bandolibre/bandolibre/README.md

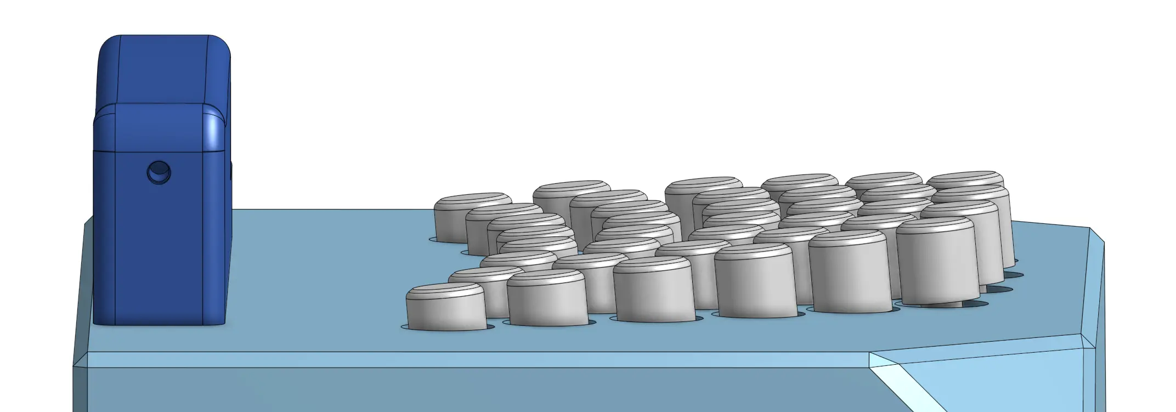
[picture p1: docs/guide/images/3dmodel_keyboard_tilt.webp]
Bandolibre keyboard


🇬🇧 **English** | 🇫🇷 [Français](README.fr.md) | 🇪🇸 [Español](README.es.md)

# Bandolibre

An open-source MIDI controller that brings the Argentine bandoneon into the digital age.

**Bandolibre focuses on one goal:** turning key presses and bellows movement into MIDI — faithfully, instantly, and without the cost or noise of an acoustic instrument. Plug it into any computer, tablet, or phone over USB and you're ready to play, compose, or practice.

An open initiative by [L'Atelier du bandonéon libre](https://github.com/bandolibre)

---

## See it play

Bandolibre demo with a clarinet virtual instrument (https://youtu.be/6s1wlRKlAk4)

Watch the demos: [with a clarinet virtual instrument](https://youtu.be/6s1wlRKlAk4) · [with strings virtual instruments](https://youtu.be/nJ0j7DtbYDk).

---

## Who is it for?

- **Students** who don't own an instrument yet and want to start learning
- **Players** who want to practice silently — at home, on the road, at any hour
- **Composers** entering scores into notation software one note at a time
- **Musicians** triggering synths and samplers on stage or in the studio

---

## How it works

- **142-key Rheinische Lage layout** — both hands, exact fingering of the Argentine bandoneon
- **Hall-effect sensors** on every key — no mechanical contact, no wear, scanned 2400 times per second
- **Blade spring + sensor pair** for the bellows — measures push/pull effort and emits MIDI CC#11 (Expression), just like the real thing
- **Two 6.35 mm expression pedal inputs** — compatible with M-Audio EX-P pedals; pedal 1 sends CC#1 (Modulation), pedal 2 sends CC#4 (Foot Controller)
- **USB-MIDI** out of the box — plug into any DAW, notation app, or synth; no drivers needed

---

## Features

**Keyboard system** — a button cycles through the three keyboard systems: Rheinische Tonlage (bisonoric, 142 tones), Peguri, or Manoury.

**Table mode** — a button toggles table mode: keys fire immediately at fixed velocity, no bellows movement required. Handy for entering a score note by note without working the bellows.

**Play anywhere** — Bandolibre is bus-powered over USB; any phone, tablet, or laptop with a soft synth becomes the sound engine. A small USB hub with a headphone jack and a power pass-through gives you audio, charging, and MIDI from a single cable — tested and pocket-sized.

**Adaptable** — standard USB-MIDI is compatible with the whole adapter ecosystem: plug in a USB Bluetooth MIDI adapter to play wirelessly, or a USB-to-DIN-5 adapter to drive vintage hardware synths.



---

## Anyone can build it

This is a fully open DIY project. PCBs are designed for economic JLCPCB two-layer fabrication — affordable and easy to order. The mechanical parts are 3D-printable (a FabLab near you works great). Firmware is open-source and flashable with a standard [ST-LINK probe](https://www.st.com/en/development-tools/stlink-v3minie.html) and a [TC-2070-IDC-050](https://www.tag-connect.com/product/tc2070-idc-050) cable.

Building one costs about as much as a decent MIDI keyboard or a good pair of studio headphones like the DT-770 Pro.

The parts list, tools, consumables and step-by-step assembly are in the assembly instructions:



They are best built in batches of five — JLCPCB minimum orders make that the natural unit. Team up with friends or reach out to [L'Atelier du bandonéon libre](https://github.com/bandolibre) to express interest in a community build.

At fifty units, PCB fabrication and Gateron switches — the two biggest line items — drop by half again.

- **Firmware:** see [`code/`](code/) — build with `just build` and `just flash`, flash via ST-LINK
- **Firmware updates:** from the browser with the [software update tool](https://bandolibre.github.io/bandolibre/update/), over the USB cable; or hold the left function button at power-on and drop the `.uf2` file onto the drive that appears — no programmer needed

---

## Configuration tool

The configuration tool is a web page that displays and changes the instrument's parameters over USB-MIDI — it works on a computer, tablet or phone. It lets you tune the bellows by dragging the push and pull curves (or picking a preset) to shape how effort turns into expression, and calibrate the rest position. Changes apply immediately, so you can adjust the feel while playing. It also calibrates the pedals, switches keyboard system, bellows program and table mode, edits every firmware property, and shows both keyboards live as you play.



<p>
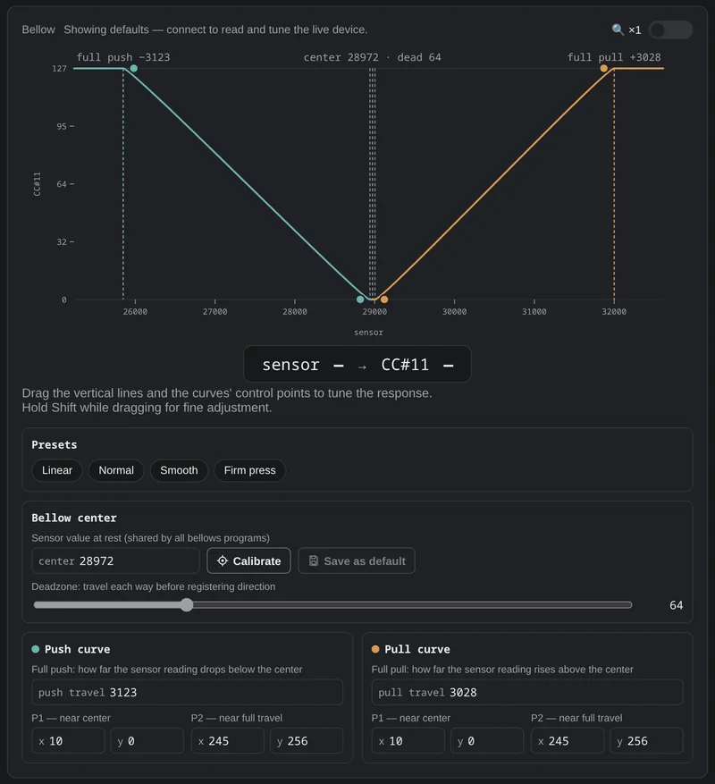
[picture p2: docs/guide/images/configuration_tool.webp]
Configuration tool, bellows curve
  
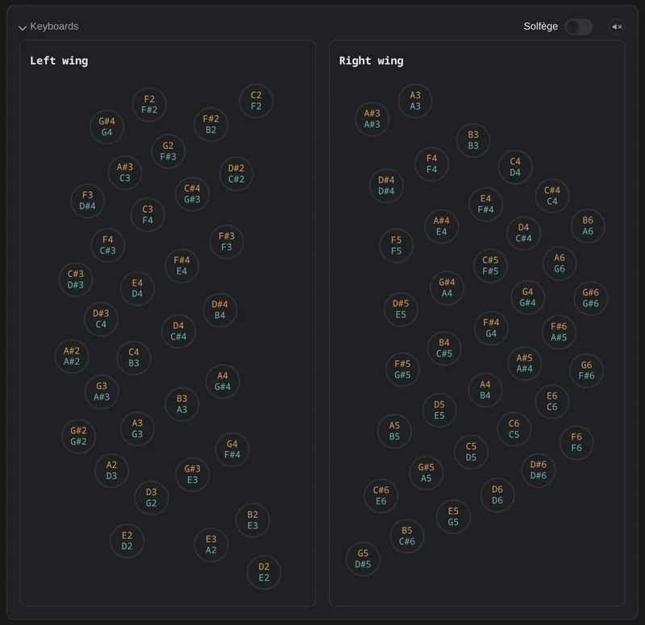
[picture p3: docs/guide/images/configuration_tool_keyboard.webp]
Configuration tool, live keyboards
  
</p>

---

## Software update

The software update tool installs the latest firmware from the browser, over the same USB cable — nothing to install, no button to hold. It shows the installed version, says when an update is available and follows every page as it is written and checked. An interrupted update is safe: the instrument waits in its update mode until it is resumed.



---

## Design

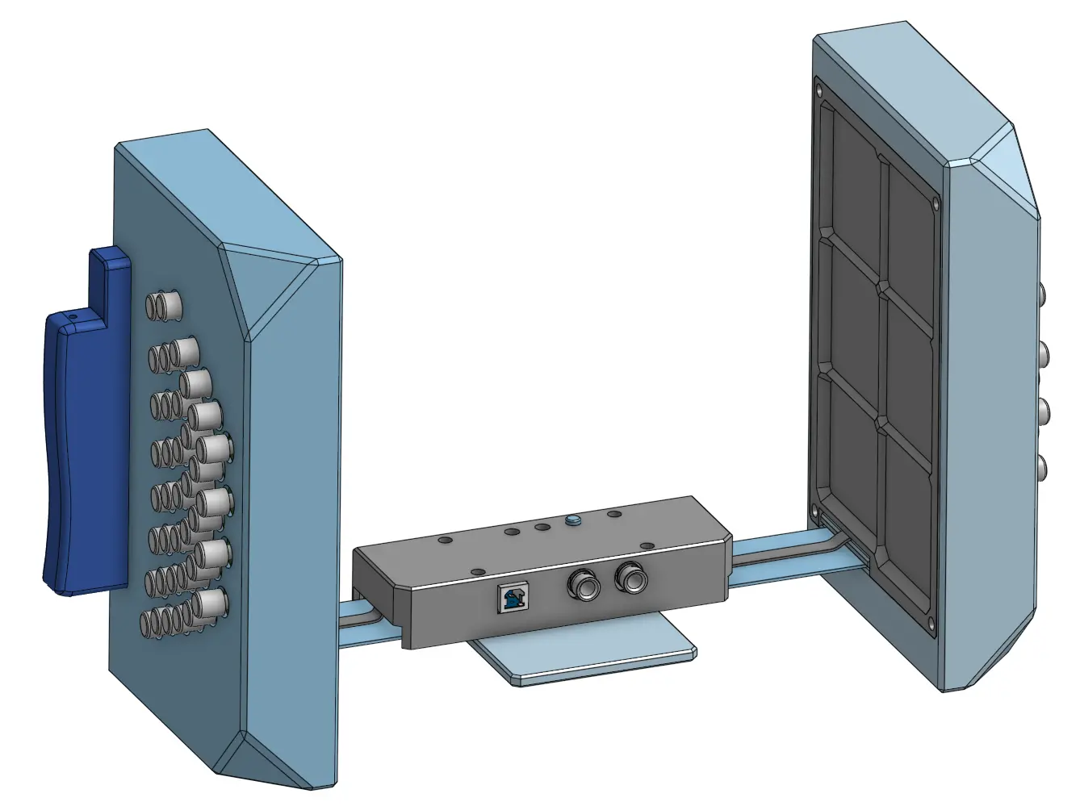
[picture p4: docs/guide/images/3dmodel_overview.webp]
overview


The mechanical parts are modeled in Onshape — [the full 3D model](https://cad.onshape.com/documents/313e70e978bf056a8dd7d76c/v/5c5fbc4088ac379c1bd1b53a/e/c6a89cb028bdc195ff70596f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) is public and interactive. Reference [photography](keyboard_picture/) of real instruments was used to accurately reproduce the shape, key placement, and keyboard tilt of both hands.
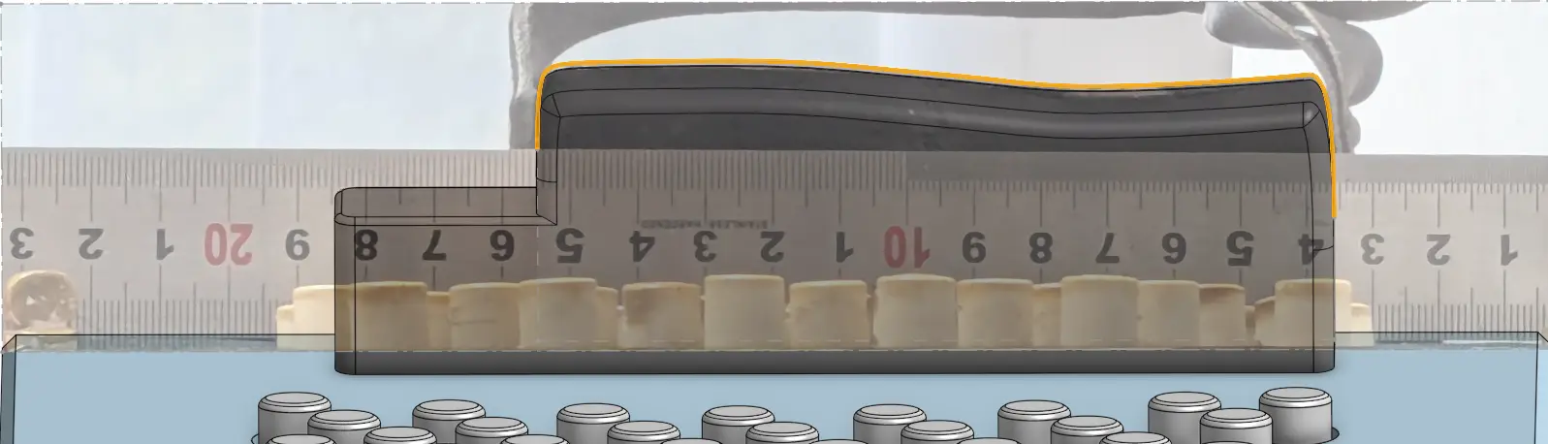
[picture p5: docs/guide/images/3dmodel_handle.webp]
handle_layout

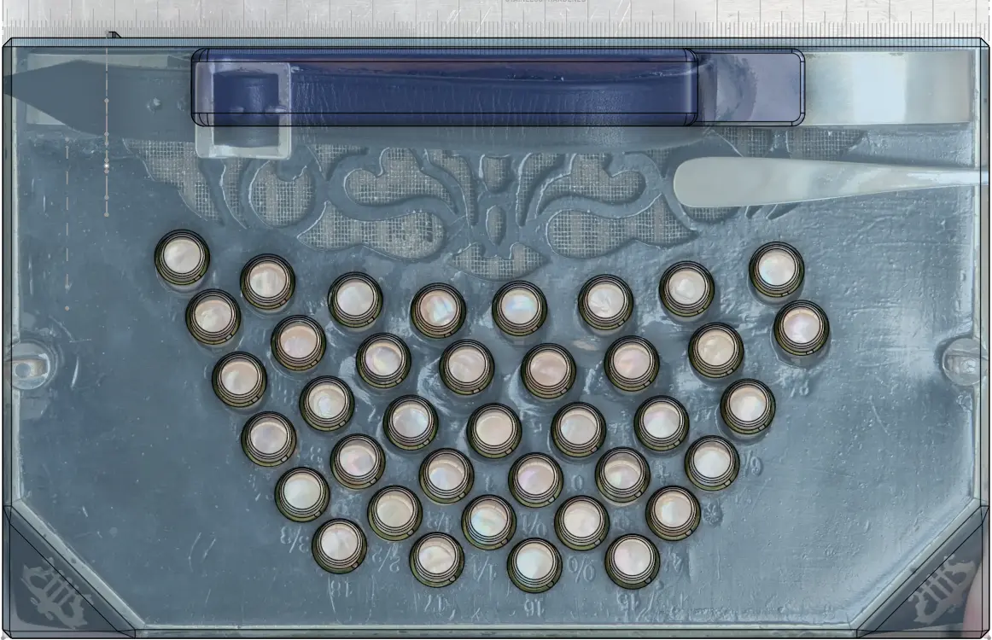
[picture p6: docs/guide/images/3dmodel_keyboard_layout.webp]
keyboard_layout


The PCBs are designed with EasyEDA.
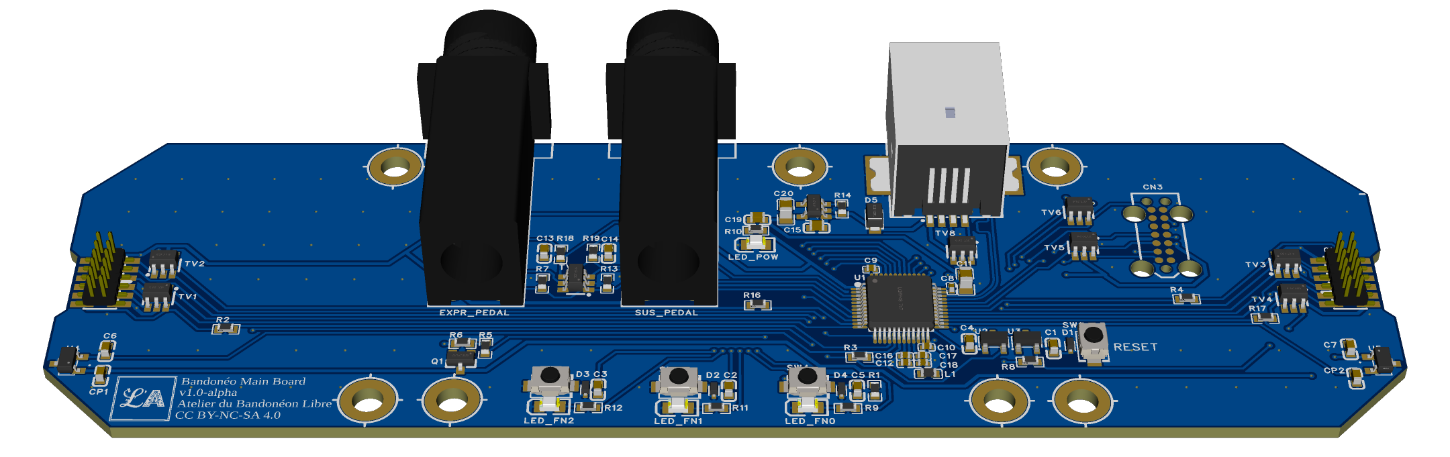
[picture p7: docs/guide/images/pcb_main_board_3d.png]
3d_pcb


The bellows is replaced by a **blade spring instrumented with two Hall-effect sensors** that read its flexion. Load cell solutions were ruled out early — they are too rigid and remove the tactile feedback players rely on to feel and modulate their effort — it plays like pressing on a wall. The blade spring preserves that proprioceptive feedback while being simple and durable. Blade thickness can be chosen to tune the instrument's stiffness, from light to firm.

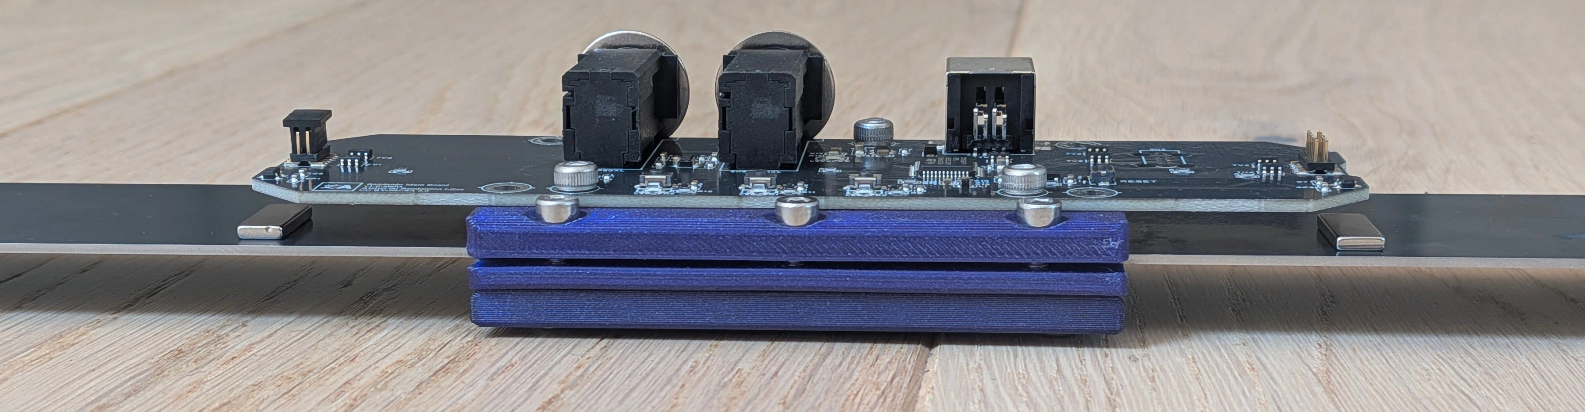
[picture p8: docs/guide/images/bandolibre_blade.webp]
blade spring


A bellows program button cycles through three bellows programs, each with its own rest position, dead zone, full travel and response curves, tuned in the configuration tool. By default they need less and less bellows travel to reach full expression — useful for quiet practice or a stiffer spring.

---

## Sound

The best match so far is the **SWAM** family of simulation instruments from [Audio Modeling](https://audiomodeling.com/): they are physically modelled rather than sampled, so CC#11 continuously drives the model itself. Bellows intensity comes out as real dynamics — timbre changing with pressure, notes swelling and dying under the bellows — instead of a volume fade over a fixed sample. [Native Instruments Session Strings](https://www.native-instruments.com/en/products/komplete/cinematic/session-strings-2) also works very well.

Modern bandoneon libraries, oddly enough, work poorly for us. They either assume the wrong keyboard layout — chromatic or accordion mappings, with no push/pull distinction — or offer only shallow CC#11 support, with dynamics baked into velocity-triggered samples that the bellows cannot reshape once a note has started.

For practice — and especially on a phone — a simple bandoneon soundfont is enough: [European Bandoneon V2.5 by Jörg Bleymehl](https://musical-artifacts.com/artifacts/1862) gives good results. It loads in any SF2-capable player, costs almost nothing in CPU, and turns a phone or tablet into a usable practice rig without a laptop or a plugin host.

So we are actively looking for virtual instruments with deep expressive support — rich polyphony and CC#11 as a primary articulation driver. If you know of one, or want to help build something tailored to the bandoneon, suggestions and contributions are very welcome.

---

## Where we are

<p>
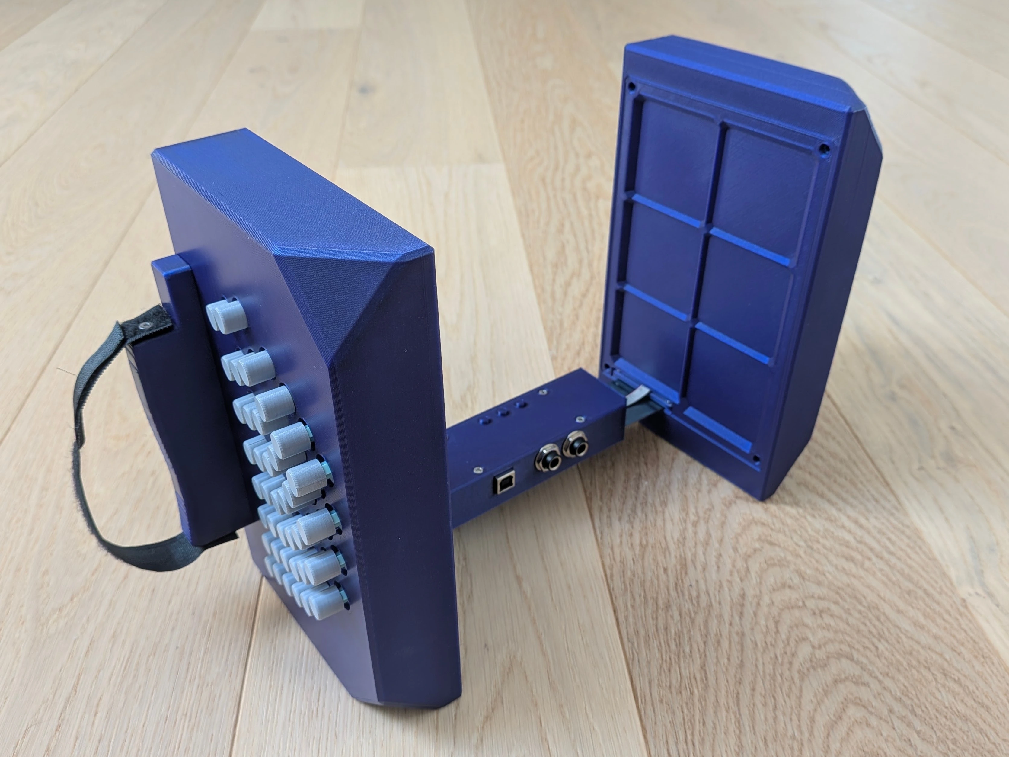
[picture p9: docs/guide/images/bandolibre_overview.webp]
Bandolibre overview
  
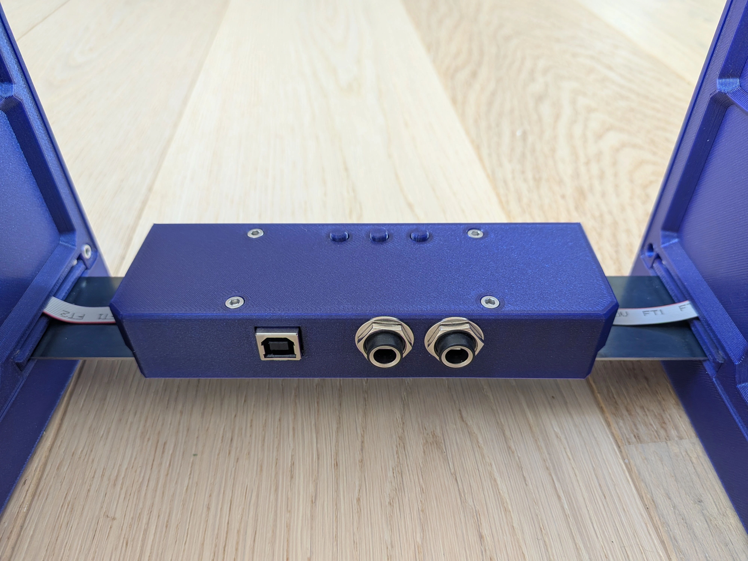
[picture p10: docs/guide/images/bandolibre_main_module.webp]
Bandolibre main module
  
</p>

Five units are built and working. The firmware handles all 142 keys, bellows push/pull, pedals, and MIDI output reliably. These instruments are currently on loan to bandoneon teachers who are giving us hands-on feedback while we polish the software.

The 3D models and PCB designs are solid — no rework planned there. The active focus right now is tuning the bellows simulation: getting the inertia model right so that short notes feel like the real instrument, not like a sensor.

There is a lot to explore on the software side. Because Hall-effect sensors measure key position continuously — not just on/off — the firmware has access to the full travel of every key at all times. This opens the door to **MPE (MIDI Polyphonic Expression)**: per-note pressure, slide, and lift curves, independently for each of the 142 keys simultaneously.

---

## How to get a device

Bandolibre stays a DIY project: the design is open and anyone can build one. We are polishing the software and collecting feedback on the hardware.

We also miss the paperwork that would allow the association handle a transaction  — passing on boards, a kit, or a finished instrument to someone who asks. 

If you'd like to hear from us when it becomes possible:



It is useful for us to see how many people are interested and what they'd play it for. Your answers stay with the association and are only used to contact you about Bandolibre.

---

## Community

Questions, ideas, or just curious?
Join [L'Atelier du bandonéon libre](https://bandolibre.github.io).

The main board communicates digitally with the wing boards and can support any layout. It is possible to design a new keyboard for a different system — Rheinische Lage, Club, Einheitsbandoneon — and reuse the main board.

Working on something similar? Let the association know — we'd love to connect.



---

## Further readings

- [Other electronic bandoneon projects](docs/guide/other-projects.md)

---

## License



Free to build, modify, and share for non-commercial use.
