bandolibre/bandolibre/code/main-g474/usb/README.md

# USB stack (TinyUSB)

The main board enumerates as a full-speed MIDI USB device built on
[TinyUSB](../../third_party/tinyusb) (git submodule, `code/third_party/tinyusb`):

| | |
|---|---|
| VID / PID | `0x0483` / `0xA5B4` (ST's vendor id, product id sublicensed from ST) |
| Manufacturer | Bandolibre |
| Product | Bandolibre |
| Serial | 96-bit chip UID, 24 hex digits |
| Interfaces | MIDI only |

`0x0483` is STMicroelectronics' USB-IF vendor id; `0xA5B4` is a product id
sublicensed from ST for this project, valid only for a product built on ST
silicon (STM32G474CBT6) and only for Bandolibre. The sublicense does not carry
USB-IF certification, so the instrument must not display the USB logo. Earlier
revisions used TinyUSB's development ids `0xCafe` / `0x4008` (`0x4000 |`
interface bitmap, computed by a `PID_MAP` macro); that macro is gone, the
product id is now fixed.

The board also carries a [bootloader](../../boot-g474/README.md), which
enumerates while firmware is being updated: MIDI, plus mass storage unless the
web update tool asked for the reboot, with manufacturer and product "Bandolibre
firmware update" (the web tools exclude that name from auto-connect). It
shares this VID/PID (one product id covers the product) and is told apart by
`bcdDevice`: `0x0101` here, `0x0203` / `0x0204` in the bootloader. The
revisions must differ because hosts cache a driver set per VID/PID/revision
and the devices expose different interfaces.

Both also carry a USB DFU runtime interface (interface 2,
`../../common/dfu/dfu_runtime.h`): a DFU tool's `DFU_DETACH` restarts the board
into the STM32's own DFU loader in ROM (`0483:df11`), keyboards connected and no
button held. `bcdUSB` is 2.1, so Windows reads the Microsoft OS 2.0 descriptors
that bind WinUSB to that interface; the revisions above were bumped from
`0x0100`, `0x0201` and `0x0202` when it was added, so Windows does not reuse
what it cached for the old layouts. The console command `romdfu` does the same
restart, for bench tests.

## Files

- `tusb_config.h` — TinyUSB feature configuration (device-only, MIDI).
- `usb_descriptors.c` — device/configuration/string descriptors. Strings are
  UTF-8 and converted to UTF-16 on the fly, so accented names work.
- `usb_app.cc/.h` — glue: `usb_app_init()` starts the stack (called from
  `main()` after `MX_USB_PCD_Init()`), `usb_app_task()` runs `tud_task()` from
  the main loop and reassembles incoming SysEx, the `usb_app_midi_*` senders
  (note, CC, 14-bit CC, active sensing, SysEx), and the three USB IRQ handlers
  (which override the weak symbols in `startup_stm32g474xx.s`).

## SysEx framing

The configuration tool talks to the firmware over SysEx (message handling in
`app/midi.cc`). Between 0xF0 and 0xF7, the body is a 16-bit XOR checksum
followed by the payload, then repacked into 7-bit groups: each run of up to 7
bytes becomes 8, a leading byte holding the seven bit-7s, then the bytes with
bit 7 cleared. ALSA and Web MIDI read any byte with bit 7 set as a new status
byte, so escaping only 0xF0/0xF7 is not enough. `CFG_TUD_MIDI_TX_BUFSIZE` is
sized to hold one full encoded response. The codec and the message ids are in
[`code/common/sysex/`](../../common/sysex), shared with the bootloader;
`docs/connect/index.html` and `docs/update/index.html` implement the host side.
Change them together.

The TinyUSB sources, include paths, and the `CFG_TUSB_MCU=OPT_MCU_STM32G4`
define are listed in the user sections of [CMakeLists.txt](../CMakeLists.txt).

## How it coexists with CubeMX

CubeMX still generates `MX_USB_PCD_Init()` (HAL PCD), which enables the USB
peripheral clock via `HAL_PCD_MspInit()`. TinyUSB's `dcd_init()` then resets
and takes over the peripheral; `HAL_PCD_Start()` is never called, so the HAL
never enables the DP pull-up or the USB interrupts itself. Don't remove the
USB peripheral from the `.ioc`.

**USB clock**: the board is crystal-less, so the `.ioc` selects HSI48 as USB
kernel clock, trimmed by the CRS against USB SOF (the PLL alternative is fed
by HSI16, ±1%, outside the USB FS ±0.25% budget). All of this lives in the
generated `SystemClock_Config()`. These `.ioc` invariants — HSI48 + CRS, USB
device FS enabled, USB interrupts *not* enabled in the NVIC tab (TinyUSB owns
the handlers) — are checked by `code/tests/test_usb_config.py` (`just test`
from `code/tests`).

## Testing

```sh
lsusb -d 0483:a5b4       # device present (bcdDevice 0101; 0203 or 0204 = bootloader, see boot-g474)
amidi -l                 # MIDI port listed as "Bandolibre"
aseqdump -p Bandolibre &   # then run `midi [note]` in the console to test
```

The `midi [note]` console command (via USART1/ST-Link) sends a note-on/note-off
pair (default 69 = A4) for end-to-end checking over USB MIDI.
