bandolibre/bandolibre/docs/index.md

---
# The wordmark (_includes/head/custom.html); the page <title> and og:title,
# which the comments are keyed on, strip the tags and stay "Bandolibre".
title: '<span class="wordmark"><span class="bando">Bando</span>libre</span>'
layout: single
classes: wide
permalink: /
hidden: true
header:
  overlay_color: "#5e616c"
  overlay_image: assets/images/readme_tilted.webp
excerpt: Un instrument MIDI pour les bandonéonistes
comments: true
author_profile: true
toc: true
toc_label: "Sur cette page"
toc_icon: "columns"
---

Le **Bandolibre** est un contrôleur MIDI conçu pour les passionnés, qui recrée
fidèlement la disposition du mythique bandonéon argentin et son clavier
"Rheinische Lage" à 142 voies.

<figure class="video_container">
  <iframe width="560" height="315" src="https://www.youtube-nocookie.com/embed/6s1wlRKlAk4" title="Bandolibre" frameborder="0" allow="accelerometer; autoplay; clipboard-write; encrypted-media; gyroscope; picture-in-picture" allowfullscreen></iframe>
</figure>

Grâce à ses capteurs magnétiques à **effet Hall**, la position de chaque touche
est mesurée **2400 fois par seconde**, offrant une précision et une réactivité
exceptionnelles, sans aucune usure mécanique.

Il se connecte en **USB-MIDI** (connecteur Type-B), directement alimenté
par le port USB — aucune batterie, aucun adaptateur, aucun câble supplémentaire.

<figure>
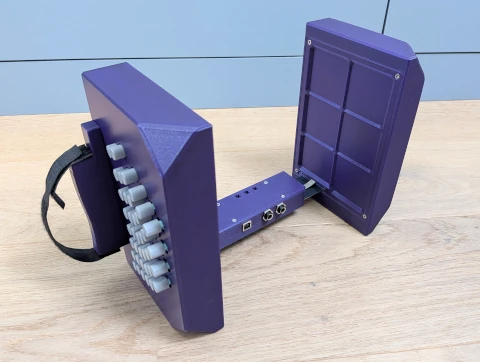
[picture p11: docs/assets/images/bandolibre_sideview.webp]
Vue de coté du bandolibre
  
</figure>

## Une Philosophie Ouverte et Communautaire

1. **Une Conception Libre** 

   Le Bandolibre est un projet entièrement open-source. Tous les plans des pièces
   mécaniques et des circuits électroniques sont publiés sous licence
   [CC BY-NC-SA 4.0](https://creativecommons.org/licenses/by-nc-sa/4.0/){:target="_blank"}.

   Cela signifie que chacun est libre de le construire, de le réparer, de le
   modifier et de partager ses améliorations avec la communauté (dans un cadre
   non commercial).

   Tous les fichiers sources — schémas, PCB, firmware, mécanique — sont
   disponibles sur GitHub :

   <a href="https://github.com/bandolibre/bandolibre" class="btn btn--primary btn--large" target="_blank"><i class="fab fa-github"></i> Voir le projet sur GitHub</a>

2. **Une Plateforme Modulaire**

   Ne vous contentez pas d'un simple instrument, appropriez-vous-le !

   La conception modulaire vous invite à expérimenter : personnalisez les
   claviers, ajoutez de nouveaux capteurs, ou reprogrammez entièrement le
   logiciel pour créer l'instrument de vos rêves. Les possibilités sont
   infinies.

## Comment Obtenir Votre Bandolibre ?

Le Bandolibre n'est pas un produit commercial. C'est une aventure communautaire.
Pour obtenir le vôtre, deux chemins s'offrent à vous :

- **La Fabrication Autonome (DIY)**

  Vous avez l'âme d'un maker ? Téléchargez les fichiers, imprimez les pièces en
  3D (dans un FabLab près de chez vous, par exemple) et fabriquez vous-même les
  circuits. Vous avez le contrôle total sur chaque composant.

- **Le Kit de Développement**

  [L'Atelier du Bandonéon Libre](https://bandolibre.github.io/) permet aux membres de s'organiser pour
  réaliser des achats groupés de composants et monter leurs kits ensemble.
  C'est l'occasion de partager les coûts, de s'entraider pendant l'assemblage
  et de rejoindre une communauté de constructeurs.

## Manifester son intérêt

Il manque encore le cadre administratif qui permettrait à l'association de
conclure une transaction — céder des cartes, un kit ou un instrument fini à
quelqu'un qui le demande.

Si vous souhaitez que nous vous prévenions quand ce sera possible :

<a href="https://forms.gle/amgxEX4XTy9Jfd538" class="btn btn--primary btn--large" target="_blank"><i class="fas fa-clipboard-list"></i> Manifester son intérêt</a>

Cela nous aide aussi à voir combien de personnes sont intéressées et ce
qu'elles aimeraient en jouer. Vos réponses restent au sein de l'association et
servent uniquement à vous recontacter au sujet de Bandolibre.

## Le Manuel d'Utilisation

Tout ce qu'il faut savoir pour jouer : brancher le Bandolibre, régler votre
logiciel de musique, utiliser les boutons de fonction et les pédales, ajuster
la sensation du soufflet et mettre à jour le firmware. Aucun outil, aucune
connaissance technique n'est nécessaire.

<a href="{{ '/guide/user_manual.fr.html' | relative_url }}" class="btn btn--primary btn--large"><i class="fas fa-book-open"></i> Lire le manuel d'utilisation</a>

Également disponible en [English]({{ '/guide/user_manual.html' | relative_url }}) et en [Español]({{ '/guide/user_manual.es.html' | relative_url }}).

## Configurer votre Bandolibre

Un outil web permet de connecter le Bandolibre en USB-MIDI depuis votre
navigateur, de dialoguer avec l'appareil en **MIDI Sysex**, de visualiser le
clavier en direct et de régler les propriétés du firmware, sans rien
installer.

<a href="{{ '/connect/' | relative_url }}" class="btn btn--primary btn--large" target="_blank"><i class="fas fa-sliders-h"></i> Ouvrir l'outil de configuration</a>

## Jouer avec BandoPM, le synthétiseur en ligne

**BandoPM** est un synthétiseur de bandonéon en **modélisation physique**,
conçu pour exploiter les capteurs du Bandolibre : la vitesse des touches donne
l'attaque, la pression du soufflet pilote le souffle sur les anches.

Il tourne dans le navigateur, sans installation : branchez le Bandolibre, il
est détecté automatiquement. Le code est libre.

<a href="https://bandolibre.github.io/bandopm/" class="btn btn--primary btn--large" target="_blank"><i class="fas fa-music"></i> Ouvrir BandoPM</a>
<a href="https://github.com/bandolibre/bandopm" class="btn btn--primary btn--large" target="_blank"><i class="fab fa-github"></i> Code source de BandoPM</a>

## Mettre à Jour le Firmware

La mise à jour se fait depuis le navigateur, par le même câble USB : l'outil
de mise à jour affiche la version installée, indique quand une nouvelle
version est disponible et l'installe en suivant chaque page écrite — rien à
installer, aucun bouton à maintenir. Une mise à jour interrompue est sans
risque : l'instrument attend qu'elle reprenne.

<a href="{{ '/update/' | relative_url }}" class="btn btn--primary btn--large" target="_blank"><i class="fas fa-download"></i> Ouvrir l'outil de mise à jour</a>

Sans navigateur compatible, maintenez le bouton de fonction gauche en
branchant le câble : un lecteur USB apparaît, déposez-y le fichier `.uf2`.

## Characteristiques Techniques

- **Clavier :** Rheinische Lage 142 voies
- **Capteurs :** Technologie à effet Hall, sans contact mécanique
- **Précision :** Mesure de la position des touches 1000 fois par seconde
- **Soufflet :** Lame flexion + 2 capteurs Hall → MIDI CC#11 Expression
- **Entrées expression :** 2 × jack TRS 6.35 mm (CC#1 Modulation, CC#4 Foot Controller)
- **Connectique :** USB-MIDI (connecteur Type-B, alimentation bus USB)
- **Microcontrôleur :** STM32G474CBT6 (identique sur les 3 cartes)
- **Firmware :** Open-source, reprogrammable via connecteur ST-LINK

## État d'Avancement du Projet

Retrouvez tous les détails techniques, le code source et les fichiers de fabrication sur

<a href="https://github.com/bandolibre/bandolibre" class="btn btn--primary btn--large" target="_blank"><i class="fab fa-github"></i> Voir le projet sur GitHub</a>

## Rejoignez la Communauté !

Vous avez des questions, des idées ?<br/>
rejoignez [l'Atelier du Badonéon Libre](https://bandolibre.github.io/)
