bandolibre/bandolibre/docs/assets/images/bandolibre-feature.webp

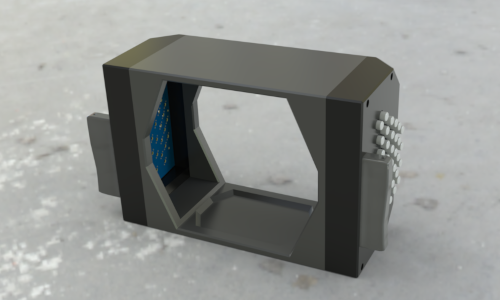
docs/assets/images/bandolibre-feature.webp
