bandolibre/bandolibre/docs/assets/images/portrait.webp

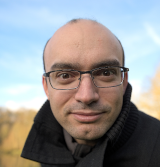
docs/assets/images/portrait.webp
