bandolibre/bandolibre/docs/assets/images/readme_tilted.webp

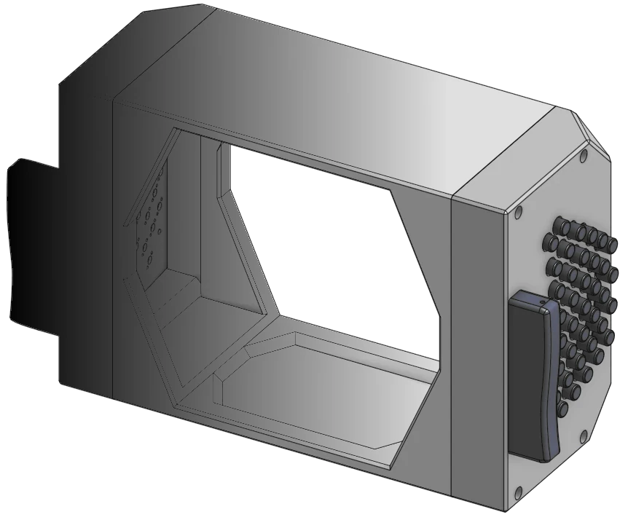
docs/assets/images/readme_tilted.webp
