bandolibre/bandolibre/docs/guide/index.md

---
title: Guide
permalink: /guide/
---

Documentation for the Bandolibre, the open-source digital bandoneon.

## Playing

- [User manual](user_manual.md) ([Français](user_manual.fr.md), [Español](user_manual.es.md))
- [Updating the firmware](firmware_update.md)

## Building

- [Assembly instructions](assembly_instructions.md)
- [Programming the boards](programming_boards.md)
- [Development environment](development_environment.md)

## More

- [Other electronic bandoneon projects](other-projects.md)
- [Source code, hardware and releases on GitHub](https://github.com/bandolibre/bandolibre)
