bandolibre/bandolibre/(list of files, drawings)

Other design files:
boards/bandolibre.eprj
