bandolibre/bandolibre/code/wing-g474/wing-g474.ioc

Mcu.UserName=STM32G474CBTx
PA0.GPIO_Label=A_IN0
PA0.Signal=ADC2_IN1
PA1.GPIO_Label=A_IN1
PA1.Signal=ADC2_IN2
PA10.GPIO_Label=PGM_USART_RX
PA10.Signal=USART1_RX
PA13.Signal=SYS_JTMS-SWDIO
PA14.Signal=SYS_JTCK-SWCLK
PA15.GPIO_Label=PGM_DETECT
PA15.Signal=GPIO_Input
PA2.GPIO_Label=A_IN2
PA2.Signal=ADC1_IN3
PA3.GPIO_Label=A_IN3
PA3.Signal=ADC1_IN4
PA4.GPIO_Label=SPI_NSS
PA4.Signal=SPI1_NSS
PA5.GPIO_Label=SPI_SCK
PA5.Signal=SPI1_SCK
PA6.GPIO_Label=SPI_MISO
PA6.Signal=SPI1_MISO
PA7.GPIO_Label=SPI_MOSI
PA7.Signal=SPI1_MOSI
PA8.GPIO_Label=A_IN7
PA8.Signal=ADC5_IN1
PA9.GPIO_Label=A_IN6
PA9.Signal=ADC5_IN2
PB0.GPIO_Label=A_IN4
PB0.Signal=ADC3_IN12
PB1.GPIO_Label=A_IN5
PB1.Signal=ADC3_IN1
PB11.GPIO_Label=HALL_NEN
PB11.Signal=GPIO_Output
PB12.GPIO_Label=LED_FN0
PB12.Signal=GPIO_Output
PB13.GPIO_Label=SW_FN0
PB13.Signal=GPIO_Input
PB14.GPIO_Label=A_IN9
PB14.Signal=ADC4_IN4
PB15.GPIO_Label=A_IN8
PB15.Signal=ADC4_IN5
PB3.Signal=SYS_JTDO-SWO
PB6.GPIO_Label=PGM_USART_TX
PB6.Signal=USART1_TX
PB7.GPIO_Label=READY
PB7.Signal=GPIO_Output
PB8-BOOT0.GPIO_Label=BOOT0
PB8-BOOT0.Signal=GPIO_Input
PC13.GPIO_Label=ID0
PC13.Signal=GPIO_Input
PC14-OSC32_IN.GPIO_Label=ID1
PC14-OSC32_IN.Signal=GPIO_Input
PC15-OSC32_OUT.GPIO_Label=ID2
PC15-OSC32_OUT.Signal=GPIO_Input
PF0-OSC_IN.GPIO_Label=SEL0
PF0-OSC_IN.Signal=GPIO_Output
PF1-OSC_OUT.GPIO_Label=SEL1
PF1-OSC_OUT.Signal=GPIO_Output
