bandolibre/bandolibre/code/main-g474/app/midi.cc

#include "midi.h"
#include "main.h"        /* HAL_GetTick */
#include "properties.h"
#include "sysex_ids.h"   /* message ids, shared with the bootloader */
#include "usb_app.h"
#include "version.h"     /* FIRMWARE_VERSION_STRING, generated from the git tag */

extern "C" {
#include "bellow.h"
#include "bootloader.h"
#include "keyboard.h"
#include "lease.h"
#include "pedals.h"
}

#include <stdio.h>
#include <stdlib.h>
#include <string.h>
#include <stdint.h>
#include <array>
#include <gsl/span>

namespace {

/* Status byte of the GET/SET_SAVED_VALUE response. */
enum saved_value_status : uint8_t {
  SAVED_STATUS_NONE      = 0,  /* no saved value; the value field is the factory value */
  SAVED_STATUS_SAVED     = 1,  /* the value field is the saved value */
  SAVED_STATUS_TRANSIENT = 2,  /* this property is never saved */
  SAVED_STATUS_ERROR     = 3,  /* flash write failed, or saving is disabled */
};

/* Operation byte of SET_SAVED_VALUE. */
enum saved_value_op : uint8_t {
  SAVED_OP_CLEAR = 0,
  SAVED_OP_SET   = 1,
};

/* Reads sysex message fields off the front of a span, advancing an internal
 * cursor. Each read returns false (leaving the cursor at the short read) if
 * not enough bytes remain. */
class DataReader {
 public:
  explicit DataReader(gsl::span<const uint8_t> data) : data_(data) {}

  bool readUInt8(uint8_t *out)
  {
    if (pos_ >= data_.size()) return false;
    *out = data_[pos_++];
    return true;
  }

  bool readUInt16(uint16_t *out)
  {
    uint8_t lo, hi;
    if (!readUInt8(&lo) || !readUInt8(&hi)) return false;
    *out = (uint16_t)(lo | (uint16_t)(hi << 8));
    return true;
  }

  /* Reads a NUL-terminated string, returning it (without the NUL) as a span
   * into the original buffer. */
  bool readString(gsl::span<const char> *out)
  {
    size_t start = pos_;
    while (pos_ < data_.size() && data_[pos_] != '\0') pos_++;
    if (pos_ >= data_.size()) return false;
    *out = gsl::span<const char>(reinterpret_cast<const char *>(data_.data() + start), pos_ - start);
    pos_++;
    return true;
  }

  size_t position() const { return pos_; }

 private:
  gsl::span<const uint8_t> data_;
  size_t pos_ = 0;
};

/* Writes sysex message fields into a fixed buffer, advancing an internal
 * cursor. getSpan() returns the portion written so far, ready to hand to
 * usb_app_midi_send_sysex. */
class DataWriter {
 public:
  explicit DataWriter(gsl::span<uint8_t> buf) : buf_(buf) {}

  bool write(uint8_t v)
  {
    if (pos_ >= buf_.size()) return false;
    buf_[pos_++] = v;
    return true;
  }

  bool write(uint16_t v)
  {
    return write((uint8_t)(v & 0xff)) && write((uint8_t)(v >> 8));
  }

  /* Writes the string's bytes followed by a NUL, the counterpart to
   * DataReader::readString. */
  bool write(gsl::span<const char> s)
  {
    for (char c : s)
      if (!write((uint8_t)c)) return false;
    return write((uint8_t)'\0');
  }

  size_t position() const { return pos_; }

  gsl::span<const uint8_t> getSpan() const { return buf_.first(pos_); }

 private:
  gsl::span<uint8_t> buf_;
  size_t pos_ = 0;
};

void send_hello_response()
{
  std::array<uint8_t, 128> payload;
  DataWriter writer(payload);

  /* The part common to both modes (the bootloader answers HELLO too, see
   * sysex_ids.h): version, mode, then the generation of the saved-values
   * store (property_store.h), 0 if nothing is saved. */
  writer.write((uint8_t)SYSEX_MSG_HELLO);
  writer.write(gsl::span<const char>(FIRMWARE_VERSION_STRING, strlen(FIRMWARE_VERSION_STRING)));
  writer.write((uint8_t)SYSEX_MODE_INSTRUMENT);
  writer.write(property_store_status().generation);
  /* Instrument mode only. */
  writer.write((uint16_t)property_count());
  /* Wing id of each keyboard (0 if that side hasn't sent a good frame yet,
   * e.g. not connected), left then right. */
  writer.write((uint8_t)keyboard_wing_id(SIDE_LEFT));
  writer.write((uint8_t)keyboard_wing_id(SIDE_RIGHT));
  /* Effective bellows direction at connect time (bellows_t's raw encoding),
   * so a client that just connected knows the initial state without waiting
   * for the next midi_send_bellows_direction() change notification. */
  writer.write((uint8_t)keyboard_bellows_direction());

  gsl::span<const uint8_t> body = writer.getSpan();
  usb_app_midi_send_sysex(body.data(), body.size());
}

/* The push notifications (bellows direction, property changed, key strike,
 * key release) are only for the configuration tool, so they are sent only while it holds a
 * lease, renewed by each MONITOR_LEASE request it polls every 100 ms. Any
 * other MIDI client (a DAW recording the port) gets no sysex it didn't ask
 * for, and the pushes stop within MONITOR_LEASE_MS of the tool closing. The
 * tool reads the state they would have announced (HELLO's bellows direction,
 * the properties) when it connects, so nothing is lost before its first poll. */
constexpr uint32_t MONITOR_LEASE_MS = 2000;
lease_t monitor_lease;

bool monitor_leased()
{
  return lease_held(&monitor_lease, HAL_GetTick(), MONITOR_LEASE_MS);
}

/* bandopm's attack & release mode wants key-speed velocities. When a synth
 * first renews the velocity lease, velocity_source is set to 1 (key speed);
 * VELOCITY_LEASE_MS after its last renewal, the value it had before comes
 * back, unless something else changed it meanwhile. Live values only: nothing
 * is saved. Both changes are pushed as PROPERTY_CHANGED, so an open
 * configuration tool shows them. */
constexpr uint32_t VELOCITY_LEASE_MS = 2000;
lease_t velocity_lease;
bool velocity_lease_active = false;
uint16_t velocity_source_before;

void set_velocity_source(uint16_t value)
{
  size_t index;
  if (!property_by_name("velocity_source", &index)) return;
  property_set_value(index, value);
  midi_send_property_changed(index);
}

void renew_velocity_lease()
{
  lease_renew(&velocity_lease, HAL_GetTick());
  if (velocity_lease_active) return;
  velocity_lease_active = true;
  velocity_source_before = g_properties->velocity_source;
  if (velocity_source_before != 1) set_velocity_source(1);
}

/* Restores velocity_source once the lease has lapsed. From midi_poll. */
void check_velocity_lease()
{
  if (!velocity_lease_active || lease_held(&velocity_lease, HAL_GetTick(), VELOCITY_LEASE_MS)) return;
  velocity_lease_active = false;
  if (g_properties->velocity_source == 1 && velocity_source_before != 1)
    set_velocity_source(velocity_source_before);
}

/* Renews the monitor lease, and answers with the live state. Raw ADC
 * readings, for diagnostics/calibration: the bellows' two hall sensors and
 * both pedal wipers (each paired with its presence flag, since a disconnected
 * pedal's ADC value is floating and meaningless). Then the settings the
 * function buttons change (table_mode, keyboard_tuning, bellow_program), so a
 * button press shows up in the tool without a property read of each. Last,
 * the key most recently pressed (wing id, 0 if none yet; key index) and its
 * live hall reading, for the tool's key sensor graph; an older tool stops
 * reading before it. */
void handle_monitor_lease()
{
  lease_renew(&monitor_lease, HAL_GetTick());

  uint16_t hall0, hall1;
  bellow_get_raw(&hall0, &hall1);

  uint16_t pedal1_sample, pedal2_sample;
  bool pedal1_connected, pedal2_connected;
  pedals_get_raw(&pedal1_sample, &pedal1_connected, &pedal2_sample, &pedal2_connected);

  uint8_t last_wing = 0, last_key = 0;
  uint16_t last_value = 0;
  if (!keyboard_last_key(&last_wing, &last_key, &last_value)) last_wing = 0;

  std::array<uint8_t, 20> payload;
  DataWriter writer(payload);

  writer.write((uint8_t)SYSEX_MSG_MONITOR_LEASE);
  writer.write(hall0);
  writer.write(hall1);
  writer.write((uint8_t)(pedal1_connected ? 1 : 0));
  writer.write(pedal1_sample);
  writer.write((uint8_t)(pedal2_connected ? 1 : 0));
  writer.write(pedal2_sample);
  writer.write((uint8_t)(g_properties->table_mode ? 1 : 0));
  writer.write((uint8_t)g_properties->keyboard_tuning);
  writer.write((uint8_t)g_properties->bellow_program);
  writer.write(last_wing);
  writer.write(last_key);
  writer.write(last_value);

  gsl::span<const uint8_t> body = writer.getSpan();
  usb_app_midi_send_sysex(body.data(), body.size());
}

/* Reads a property's current value regardless of its underlying type (bool
 * reads back as 0/1, a point as x | y << 8). False if index is out of range. */
bool get_property_raw(size_t index, uint16_t *out)
{
  if (!property_at(index)) return false;
  *out = property_value(index);
  return true;
}

/* Writes a property's value regardless of its underlying type (bool takes
 * value != 0); clamps to [min,max]. False if index is out of range. */
bool set_property_raw(size_t index, uint16_t value)
{
  return property_set_value(index, value);
}

void send_index_value_response(sysex_message_id message_id, uint16_t index, uint16_t value)
{
  std::array<uint8_t, 8> payload;
  DataWriter writer(payload);

  writer.write((uint8_t)message_id);
  writer.write(index);
  writer.write(value);

  gsl::span<const uint8_t> body = writer.getSpan();
  usb_app_midi_send_sysex(body.data(), body.size());
}

void handle_get_property(gsl::span<const uint8_t> body)
{
  DataReader reader(body);
  uint16_t index;
  if (!reader.readUInt16(&index)) {
    printf("sysex: get_property: malformed request\r\n");
    return;
  }

  uint16_t value;
  if (!get_property_raw(index, &value)) {
    printf("sysex: get_property: bad index %u\r\n", index);
    return;
  }

  send_index_value_response(SYSEX_MSG_GET_PROPERTY, index, value);
}

void handle_get_property_description(gsl::span<const uint8_t> body)
{
  DataReader reader(body);
  uint16_t index;
  if (!reader.readUInt16(&index)) {
    printf("sysex: get_property_description: malformed request\r\n");
    return;
  }

  const property_desc_t *d = property_at(index);
  if (!d) {
    printf("sysex: get_property_description: bad index %u\r\n", index);
    return;
  }

  std::array<uint8_t, 200> payload;
  DataWriter writer(payload);

  writer.write((uint8_t)SYSEX_MSG_GET_PROPERTY_DESCRIPTION);
  writer.write(index);
  writer.write((uint8_t)d->type);
  writer.write(d->factory_value);
  writer.write(gsl::span<const char>(d->name, strlen(d->name)));
  writer.write(gsl::span<const char>(d->description, strlen(d->description)));

  gsl::span<const uint8_t> response_body = writer.getSpan();
  usb_app_midi_send_sysex(response_body.data(), response_body.size());
}

void handle_set_property(gsl::span<const uint8_t> body)
{
  DataReader reader(body);
  uint16_t index, value;
  if (!reader.readUInt16(&index) || !reader.readUInt16(&value)) {
    printf("sysex: set_property: malformed request\r\n");
    return;
  }

  if (!set_property_raw(index, value)) {
    printf("sysex: set_property: bad index %u\r\n", index);
    return;
  }

  /* Echo back the value actually in effect: property_set_value clamps to
   * [min,max], so it may differ from what was requested. */
  uint16_t new_value;
  get_property_raw(index, &new_value);
  send_index_value_response(SYSEX_MSG_SET_PROPERTY, index, new_value);
}

/* [id, u16 index, u8 status, u16 value]: the saved state of one property. A
 * failed write reports SAVED_STATUS_ERROR with the property's current default;
 * the client re-reads to learn what the flash still holds. */
void write_saved_state(DataWriter &writer, uint16_t index, bool failed)
{
  const property_desc_t *d = property_at(index);
  uint8_t status;
  uint16_t value = property_default(index);
  if (failed) status = SAVED_STATUS_ERROR;
  else if (d->tag == PROPERTY_TAG_NONE) status = SAVED_STATUS_TRANSIENT;
  else if (property_get_saved(index, &value)) status = SAVED_STATUS_SAVED;
  else status = SAVED_STATUS_NONE;
  writer.write(status);
  writer.write(value);
}

void send_saved_value_response(sysex_message_id message_id, uint16_t index, bool failed)
{
  std::array<uint8_t, 8> payload;
  DataWriter writer(payload);
  writer.write((uint8_t)message_id);
  writer.write(index);
  write_saved_state(writer, index, failed);

  gsl::span<const uint8_t> body = writer.getSpan();
  usb_app_midi_send_sysex(body.data(), body.size());
}

void handle_get_saved_value(gsl::span<const uint8_t> body)
{
  DataReader reader(body);
  uint16_t index;
  if (!reader.readUInt16(&index)) {
    printf("sysex: get_saved_value: malformed request\r\n");
    return;
  }
  if (!property_at(index)) {
    printf("sysex: get_saved_value: bad index %u\r\n", index);
    return;
  }
  send_saved_value_response(SYSEX_MSG_GET_SAVED_VALUE, index, false);
}

/* Writes flash: an append is ~85 us, but a compaction erases a page and
 * stalls the CPU for ~22 ms. Runs from midi_poll(), in the main loop. */
void handle_set_saved_value(gsl::span<const uint8_t> body)
{
  DataReader reader(body);
  uint16_t index, value;
  uint8_t op;
  if (!reader.readUInt16(&index) || !reader.readUInt8(&op) || !reader.readUInt16(&value)) {
    printf("sysex: set_saved_value: malformed request\r\n");
    return;
  }
  const property_desc_t *d = property_at(index);
  if (!d) {
    printf("sysex: set_saved_value: bad index %u\r\n", index);
    return;
  }

  property_save_result_t const r =
      op == SAVED_OP_SET ? property_set_saved(index, value) : property_clear_saved(index);
  bool const failed = r == PROPERTY_SAVE_FLASH_ERROR || r == PROPERTY_SAVE_DISABLED;
  if (failed) printf("sysex: set_saved_value: %s failed (%d)\r\n", d->name, (int)r);
  send_saved_value_response(SYSEX_MSG_SET_SAVED_VALUE, index, failed);
}

/* [id, u8 status]: 0 if every saved value is gone, else the
 * property_save_result_t error. Live values return to factory either way. */
void handle_factory_reset()
{
  property_save_result_t const r = property_factory_reset();
  printf("sysex: factory reset%s\r\n", r == PROPERTY_SAVE_OK ? "" : " FAILED");
  uint8_t payload[2] = { (uint8_t)SYSEX_MSG_FACTORY_RESET, (uint8_t)r };
  usb_app_midi_send_sysex(payload, sizeof(payload));
}

/* [u8 seq, magic "UPDT"] -> [id, seq, status], then reboot into the
 * bootloader's MIDI-only update mode (the web update tool). The magic keeps a
 * stray or garbled frame from rebooting the instrument mid-tune. */
void handle_enter_update_mode(gsl::span<const uint8_t> body)
{
  size_t const magic_len = sizeof(SYSEX_UPDATE_MAGIC) - 1;
  if (body.size() != 1 + magic_len || memcmp(body.data() + 1, SYSEX_UPDATE_MAGIC, magic_len) != 0) {
    printf("sysex: ENTER_UPDATE_MODE without its magic, ignored\r\n");
    return;
  }
  uint8_t payload[3] = { (uint8_t)SYSEX_MSG_ENTER_UPDATE_MODE, body[0], (uint8_t)UPDATE_OK };
  usb_app_midi_send_sysex(payload, sizeof(payload));
  printf("sysex: rebooting into firmware update mode\r\n");
  reboot_to_bootloader(false);   /* serves USB for 50 ms first, so the reply leaves */
}

}  /* namespace */

void midi_sysex_received(gsl::span<const uint8_t> data)
{
  // `data` is the message identifier and body: usb_app.cc has already
  // stripped and checksum-verified the 0xF0/checksum/0xF7 framing (dumping
  // the raw frame and logging any discard along the way) before calling this.
  if (data.empty()) {
    printf("sysex: empty message\r\n");
    return;
  }

  uint8_t message_id = data[0];
  gsl::span<const uint8_t> body = data.subspan(1);
  switch (message_id) {
    case SYSEX_MSG_HELLO:
      send_hello_response();
      break;
    case SYSEX_MSG_GET_PROPERTY:
      handle_get_property(body);
      break;
    case SYSEX_MSG_GET_PROPERTY_DESCRIPTION:
      handle_get_property_description(body);
      break;
    case SYSEX_MSG_SET_PROPERTY:
      handle_set_property(body);
      break;
    case SYSEX_MSG_MONITOR_LEASE:
      handle_monitor_lease();
      break;
    case SYSEX_MSG_VELOCITY_LEASE:
      renew_velocity_lease();
      break;
    case SYSEX_MSG_GET_SAVED_VALUE:
      handle_get_saved_value(body);
      break;
    case SYSEX_MSG_SET_SAVED_VALUE:
      handle_set_saved_value(body);
      break;
    case SYSEX_MSG_FACTORY_RESET:
      handle_factory_reset();
      break;
    case SYSEX_MSG_ENTER_UPDATE_MODE:
      handle_enter_update_mode(body);
      break;
    default:
      printf("sysex: unknown message id %u\r\n", message_id);
      break;
  }
}

void midi_send_bellows_direction(uint8_t direction)
{
  if (!monitor_leased()) return;
  uint8_t payload[2] = { (uint8_t)SYSEX_MSG_BELLOWS_DIRECTION, direction };
  usb_app_midi_send_sysex(payload, sizeof(payload));
}

/* [id, u16 speed, u8 velocity, u8 deferred] */
void midi_send_key_strike(uint16_t speed, uint8_t velocity, bool deferred)
{
  if (!monitor_leased()) return;
  std::array<uint8_t, 5> payload;
  DataWriter writer(payload);
  writer.write((uint8_t)SYSEX_MSG_KEY_STRIKE);
  writer.write(speed);
  writer.write(velocity);
  writer.write((uint8_t)(deferred ? 1 : 0));

  gsl::span<const uint8_t> body = writer.getSpan();
  usb_app_midi_send_sysex(body.data(), body.size());
}

/* [id, u16 speed, u8 velocity, u8 neutral] */
void midi_send_key_release(uint16_t speed, uint8_t velocity, bool neutral)
{
  if (!monitor_leased()) return;
  std::array<uint8_t, 5> payload;
  DataWriter writer(payload);
  writer.write((uint8_t)SYSEX_MSG_KEY_RELEASE);
  writer.write(speed);
  writer.write(velocity);
  writer.write((uint8_t)(neutral ? 1 : 0));

  gsl::span<const uint8_t> body = writer.getSpan();
  usb_app_midi_send_sysex(body.data(), body.size());
}

/* [id, u16 index, u16 live value, u8 status, u16 value]: the last two as in
 * the GET_SAVED_VALUE response. */
void midi_send_property_changed(size_t index)
{
  if (!monitor_leased()) return;
  uint16_t live;
  if (!get_property_raw(index, &live)) return;

  std::array<uint8_t, 8> payload;
  DataWriter writer(payload);
  writer.write((uint8_t)SYSEX_MSG_PROPERTY_CHANGED);
  writer.write((uint16_t)index);
  writer.write(live);
  write_saved_state(writer, (uint16_t)index, false);

  gsl::span<const uint8_t> body = writer.getSpan();
  usb_app_midi_send_sysex(body.data(), body.size());
}

namespace {

bool parse_arg_impl(gsl::span<const char* const> argv, size_t idx,
                    long lo, long hi, const char *what, long *out)
{
  if (idx >= argv.size()) { printf("missing %s\r\n", what); return false; }
  char *end;
  long v = strtol(argv[idx], &end, 0);
  if (argv[idx][0] == '\0' || *end != '\0') { printf("not a number: %s\r\n", argv[idx]); return false; }
  if (v < lo || v > hi) { printf("%s out of range [%ld,%ld]: %ld\r\n", what, lo, hi, v); return false; }
  *out = v;
  return true;
}

static void cmd_send_sysex(gsl::span<const char* const> argv)
{
  if (argv.size() < 2) {
    printf("usage: send_sysex <byte0> [byte1] ...\r\n");
    printf("  sends sysex message id + body bytes (in hex, decimal, or 0x prefix);\r\n");
    printf("  the 0xF0/checksum header and 0xF7 footer are added automatically\r\n");
    printf("  example: send_sysex 0x00\r\n");
    return;
  }

  std::array<uint8_t, 256> msg;
  size_t len = 0;

  for (size_t i = 1; i < argv.size() && len < msg.size(); i++) {
    char *end;
    long val = strtol(argv[i], &end, 0);
    if (argv[i][0] == '\0' || *end != '\0') {
      printf("not a number: %s\r\n", argv[i]);
      return;
    }
    if (val < 0 || val > 255) {
      printf("byte out of range [0,255]: %ld\r\n", val);
      return;
    }
    msg[len++] = (uint8_t)val;
  }

  usb_app_midi_send_sysex(msg.data(), len);
  printf("sysex sent: ");
  for (size_t i = 0; i < len; i++) printf("%02X ", msg[i]);
  printf("\r\n");
}

}  /* namespace */


void midi_poll(void)
{
  static uint32_t last_tick = 0;
  check_velocity_lease();
  if (!g_properties->midi_active_sensing_enable) return;
  uint32_t now = HAL_GetTick();
  if ((now - last_tick) < g_properties->midi_active_sensing_period) return;
  last_tick = now;
  usb_app_midi_active_sensing();
}

constexpr uint8_t MIDI_DEFAULT_VELOCITY = 64;
static void cmd_note_on(gsl::span<const char* const> argv_span)
{
  long channel, note, velocity = MIDI_DEFAULT_VELOCITY;
  if (!parse_arg_impl(argv_span, 1, 1, 16, "channel", &channel) ||
      !parse_arg_impl(argv_span, 2, 0, 127, "note", &note))
  {
    printf("usage: send_note_on <channel 1-16> <note 0-127> [velocity 0-127]\r\n");
    return;
  }
  if (argv_span.size() > 3 && !parse_arg_impl(argv_span, 3, 0, 127, "velocity", &velocity)) return;
  usb_app_midi_note_on((uint8_t)(channel - 1), (uint8_t)note, (uint8_t)velocity);
  printf("note on  ch %ld note %ld vel %ld\r\n", channel, note, velocity);
}

static void cmd_note_off(gsl::span<const char* const> argv_span)
{
  long channel, note, velocity = MIDI_NOTE_OFF_DEFAULT_VELOCITY;
  if (!parse_arg_impl(argv_span, 1, 1, 16, "channel", &channel) ||
      !parse_arg_impl(argv_span, 2, 0, 127, "note", &note))
  {
    printf("usage: send_note_off <channel 1-16> <note 0-127> [velocity 0-127]\r\n");
    return;
  }
  if (argv_span.size() > 3 && !parse_arg_impl(argv_span, 3, 0, 127, "velocity", &velocity)) return;
  usb_app_midi_note_off((uint8_t)(channel - 1), (uint8_t)note, (uint8_t)velocity);
  printf("note off ch %ld note %ld vel %ld\r\n", channel, note, velocity);
}

static void cmd_cc(gsl::span<const char* const> argv_span)
{
  long channel, controller, value;
  if (!parse_arg_impl(argv_span, 1, 1, 16, "channel", &channel) ||
      !parse_arg_impl(argv_span, 2, 0, 127, "controller", &controller) ||
      !parse_arg_impl(argv_span, 3, 0, 127, "value", &value))
  {
    printf("usage: send_cc <channel 1-16> <controller 0-127> <value 0-127>\r\n");
    return;
  }
  usb_app_midi_control_change((uint8_t)(channel - 1), (uint8_t)controller, (uint8_t)value);
  printf("cc       ch %ld ctrl %ld val %ld\r\n", channel, controller, value);
}

bool midi_console_execute(gsl::span<const char* const> argv_span)
{
  if (argv_span.empty()) return false;
  if (strcmp(argv_span[0], "send_note_on") == 0)       cmd_note_on(argv_span);
  else if (strcmp(argv_span[0], "send_note_off") == 0) cmd_note_off(argv_span);
  else if (strcmp(argv_span[0], "send_cc") == 0)       cmd_cc(argv_span);
  else if (strcmp(argv_span[0], "send_sysex") == 0)    cmd_send_sysex(argv_span);
  else return false;
  return true;
}

void midi_console_help(void)
{
  printf("\r\nMIDI commands (cable 0, channel 1-16, data 0-127):\r\n");
  printf("  send_note_on  <channel> <note> [velocity]   velocity defaults to %d\r\n", MIDI_DEFAULT_VELOCITY);
  printf("  send_note_off <channel> <note> [velocity]   velocity defaults to %d\r\n", MIDI_NOTE_OFF_DEFAULT_VELOCITY);
  printf("  send_cc       <channel> <controller> <value>\r\n");
  printf("  send_sysex    <byte0> [byte1] ...           sends id+body (hex/decimal); framing is automatic\r\n");
}

size_t midi_console_complete(const char *prefix, const char **out, size_t cap)
{
  static const char *const names[] = { "send_note_on", "send_note_off", "send_cc", "send_sysex" };
  size_t n = 0;
  size_t plen = prefix ? strlen(prefix) : 0;
  for (size_t i = 0; i < sizeof(names) / sizeof(names[0]) && n < cap; i++)
    if (strncmp(names[i], prefix ? prefix : "", plen) == 0) out[n++] = names[i];
  return n;
}
