bandolibre/bandolibre/code/main-g474/app/buttons.h

#ifndef APP_BUTTONS_H
#define APP_BUTTONS_H

#include <stdbool.h>
#include <stdint.h>

/* Three function buttons (SW_FN0..2) sit on the main board. SW_FN0 shares the
 * BOOT0 pin. Each is active-low (pressed reads GPIO_PIN_RESET). This module
 * polls all three and logs the combined state when it changes.
 *
 * FN0 (right) is a press-to-toggle for "table mode": with the instrument resting
 * on a table (bellows not held), keys still sound. It writes the table_mode
 * property rather than latching state of its own, so read it from
 * g_properties->table_mode (or via buttons_table_mode()).
 *
 * FN1 (middle) cycles the bellows program (BELLOW_PROGRAM_COUNT sets of
 * deadzone, full travel and response curves, see bellow.h), on release. It
 * writes the bellow_program property rather than latching state of its own,
 * so read it from g_properties->bellow_program. It skips a program whose
 * bellow_p<n>_in_cycle is off. Held for a second instead, it
 * calibrates the bellows center (bellow_calibrate_center()) and saves it;
 * LED_FN1 is lit for the second the calibration samples.
 *
 * FN2 (left) cycles the keyboard tuning (Rheinische -> Peguri -> Manoury and
 * back). It writes the keyboard_tuning property rather than latching state of
 * its own, so read the tuning from g_properties->keyboard_tuning. Held at
 * power-on, FN2 instead enters the UF2 bootloader; that is the bootloader's
 * own check and is unrelated to this module. */

/* Reads the three function buttons and logs the combined state on any change.
 * Call once per main loop iteration. */
void buttons_poll(void);

/* True while table mode is engaged (toggled by each press of FN0). */
bool buttons_table_mode(void);

#endif /* APP_BUTTONS_H */
