bandolibre/bandolibre/code/boot-g474/main.c

/*
 * Bandolibre bootloader.
 *
 * Reset always lands here. If nothing asks for update mode and the
 * application above looks valid, this hands over to it immediately;
 * otherwise it brings up USB as "Bandolibre firmware update": a MIDI device
 * the web update tool talks to (midi_update.c), plus, unless the web tool
 * asked for the reboot, a mass storage device called BANDOLIBRE that takes a
 * .uf2 file.
 *
 * Four things ask for update mode:
 *   - ENTER_UPDATE_MODE from the web update tool, via BOOT_FLAG_ADDR: MIDI
 *     only;
 *   - the console `dfu` command in the application, via BOOT_FLAG_ADDR;
 *   - SW_FN2 (PB4) held down at power-on;
 *   - an application that fails its vector table check, so a board whose
 *     firmware is missing or half-written recovers by itself.
 *
 * See memmap.h for the flash split and README.md for the whole picture.
 */

#include <stdbool.h>
#include <stdio.h>
#include <string.h>

#include "debug.h"
#include "dfu_runtime.h"
#include "memmap.h"
#include "midi_update.h"
#include "msc_disk.h"
#include "stm32g4xx_hal.h"
#include "tusb.h"
#include "usb_descriptors.h"

/* SW_FN2, the leftmost function button. Active low. */
#define DFU_BUTTON_PORT   GPIOB
#define DFU_BUTTON_PIN    GPIO_PIN_4

/* LED_FN2, above that button. PB5 is TIM3_CH2 (AF2), so the LED is dimmed and
 * ramped in hardware PWM rather than switched. HAL's timer module is not built
 * into the bootloader (flash budget), hence the CMSIS registers. */
#define DFU_LED_PORT      GPIOB
#define DFU_LED_PIN       GPIO_PIN_5

/* Timer period in counts (about 94 kHz at the 96 MHz bus clock, far above any
 * flicker rate), and the duty at the peak of a pulse. At full duty the LED is
 * much brighter than wanted, so the peak is capped. */
#define LED_PWM_TOP       1023U
#define LED_PEAK_DUTY     120U

static volatile uint32_t *const boot_flag = (volatile uint32_t *) BOOT_FLAG_ADDR;

void Error_Handler(void);

/* Clock tree, copied from the application's CubeMX SystemClock_Config()
 * (main-g474/Core/Src/main.c). HSI16 through the PLL for a 96 MHz core, and —
 * the part that matters here — HSI48 as the USB kernel clock with the CRS
 * trimming it against USB start-of-frame. The board is crystal-less, so
 * without the CRS the 48 MHz drifts well outside the ±0.25% that full-speed
 * USB allows and enumeration becomes unreliable.
 * code/tests/test_usb_config.py guards the .ioc side of this. */
static void SystemClock_Config(void)
{
  RCC_OscInitTypeDef osc = {0};
  RCC_ClkInitTypeDef clk = {0};
  RCC_CRSInitTypeDef crs = {0};

  HAL_PWREx_ControlVoltageScaling(PWR_REGULATOR_VOLTAGE_SCALE1);

  osc.OscillatorType = RCC_OSCILLATORTYPE_HSI | RCC_OSCILLATORTYPE_HSI48;
  osc.HSIState = RCC_HSI_ON;
  osc.HSICalibrationValue = RCC_HSICALIBRATION_DEFAULT;
  osc.HSI48State = RCC_HSI48_ON;
  osc.PLL.PLLState = RCC_PLL_ON;
  osc.PLL.PLLSource = RCC_PLLSOURCE_HSI;
  osc.PLL.PLLM = RCC_PLLM_DIV1;
  osc.PLL.PLLN = 12;
  osc.PLL.PLLP = RCC_PLLP_DIV2;
  osc.PLL.PLLQ = RCC_PLLQ_DIV4;
  osc.PLL.PLLR = RCC_PLLR_DIV2;
  if (HAL_RCC_OscConfig(&osc) != HAL_OK) Error_Handler();

  clk.ClockType = RCC_CLOCKTYPE_HCLK | RCC_CLOCKTYPE_SYSCLK |
                  RCC_CLOCKTYPE_PCLK1 | RCC_CLOCKTYPE_PCLK2;
  clk.SYSCLKSource = RCC_SYSCLKSOURCE_PLLCLK;
  clk.AHBCLKDivider = RCC_SYSCLK_DIV1;
  clk.APB1CLKDivider = RCC_HCLK_DIV1;
  clk.APB2CLKDivider = RCC_HCLK_DIV1;
  if (HAL_RCC_ClockConfig(&clk, FLASH_LATENCY_3) != HAL_OK) Error_Handler();

  __HAL_RCC_CRS_CLK_ENABLE();

  crs.Prescaler = RCC_CRS_SYNC_DIV1;
  crs.Source = RCC_CRS_SYNC_SOURCE_USB;
  crs.Polarity = RCC_CRS_SYNC_POLARITY_RISING;
  crs.ReloadValue = __HAL_RCC_CRS_RELOADVALUE_CALCULATE(48000000, 1000);
  crs.ErrorLimitValue = 34;
  crs.HSI48CalibrationValue = 32;
  HAL_RCCEx_CRSConfig(&crs);
}

/* Called by HAL_Init(). Mirrors the application's generated HAL_MspInit()
 * (main-g474/Core/Src/stm32g4xx_hal_msp.c).
 *
 * The dead-battery call is not boilerplate here — it is what makes the DFU
 * button readable at all. PB4 and PB6 are UCPD1_CC2 and UCPD1_CC1, and out of
 * reset each can carry a 5.1 kOhm pull-down from the UCPD peripheral, gated by
 * the level on PA10 and PA9 respectively (STM32G474CB datasheet, pin table
 * note 6). PA10 is this board's USART1_RX, which the attached ST-Link VCP
 * holds high while idle — so PB4's pull-down is active, it beats the ~40 kOhm
 * internal pull-up, and SW_FN2 would read as pressed forever. Setting
 * UCPD1_DBDIS in PWR_CR3 removes it. */
void HAL_MspInit(void)
{
  __HAL_RCC_SYSCFG_CLK_ENABLE();
  __HAL_RCC_PWR_CLK_ENABLE();

  HAL_PWREx_DisableUCPDDeadBattery();
}

static void gpio_init(void)
{
  __HAL_RCC_GPIOB_CLK_ENABLE();

  /* PB4 is also NJTRST and comes out of reset in its JTAG alternate function
   * (datasheet note 5), so it has to be claimed as a plain input. The board is
   * debugged over SWD, which does not use this pin. */
  GPIO_InitTypeDef in = {
    .Pin = DFU_BUTTON_PIN,
    .Mode = GPIO_MODE_INPUT,
    .Pull = GPIO_PULLUP,
  };
  HAL_GPIO_Init(DFU_BUTTON_PORT, &in);

  __HAL_RCC_TIM3_CLK_ENABLE();
  TIM3->PSC   = 0;
  TIM3->ARR   = LED_PWM_TOP;
  TIM3->CCR2  = 0;
  TIM3->CCMR1 = TIM_CCMR1_OC2M_1 | TIM_CCMR1_OC2M_2 | TIM_CCMR1_OC2PE;  /* PWM mode 1 */
  TIM3->CCER  = TIM_CCER_CC2E;
  TIM3->CR1   = TIM_CR1_ARPE;
  TIM3->EGR   = TIM_EGR_UG;
  TIM3->CR1  |= TIM_CR1_CEN;

  GPIO_InitTypeDef out = {
    .Pin = DFU_LED_PIN,
    .Mode = GPIO_MODE_AF_PP,
    .Pull = GPIO_NOPULL,
    .Speed = GPIO_SPEED_FREQ_LOW,
    .Alternate = GPIO_AF2_TIM3,
  };
  HAL_GPIO_Init(DFU_LED_PORT, &out);
}

/* Sets the LED to a duty of 0..LED_PWM_TOP. */
static void led_set(uint32_t duty)
{
  TIM3->CCR2 = duty;
}

static bool dfu_button_pressed(void)
{
  /* Let the pull-up charge the pin and the button's stray capacitance before
   * sampling; this runs microseconds after the pin was reconfigured. */
  HAL_Delay(2);
  return HAL_GPIO_ReadPin(DFU_BUTTON_PORT, DFU_BUTTON_PIN) == GPIO_PIN_RESET;
}

volatile bool flash_ecc_fault;

bool flash_read(uint32_t addr, void *dst, size_t len)
{
  flash_ecc_fault = false;
  memcpy(dst, (const void *) addr, len);
  bool const ok = !flash_ecc_fault;
  flash_ecc_fault = false;
  return ok;
}

/* Cheap sanity check on the application's vector table: a plausible initial
 * stack pointer and a reset handler inside the application region. This is
 * what catches a missing or half-written image: both update paths program the
 * first double word (these two words) last, so an interrupted update fails
 * here rather than jumping into nothing. A power cut during that very write
 * leaves it torn, which reads as an ECC error and fails too. */
bool app_valid(void)
{
  uint32_t words[2];
  if (!flash_read(APP_BASE, words, sizeof(words))) return false;
  uint32_t const sp = words[0];
  uint32_t const pc = words[1];

  if (sp < 0x20000000UL || sp > 0x20020000UL) return false;
  if (pc < APP_BASE || pc >= APP_BASE + APP_SIZE) return false;
  if ((pc & 1UL) == 0UL) return false;   /* Thumb bit */

  return true;
}

static void jump_to_app(void)
{
  uint32_t const sp = ((uint32_t const *) APP_BASE)[0];
  uint32_t const pc = ((uint32_t const *) APP_BASE)[1];

  /* Hand the application the same machine it would see after a cold reset:
   * clocks back on HSI, no peripheral left running, no interrupt pending.
   *
   * This runs with interrupts still enabled on purpose. The HAL's RCC teardown
   * polls HAL_GetTick() for its timeouts, and the tick only advances from the
   * SysTick interrupt — with interrupts off, a clock that failed to come ready
   * would spin here forever instead of returning HAL_TIMEOUT. Nothing else is
   * running to be disturbed: this path is only reached when DFU mode was not
   * entered, so USB was never initialised and SysTick is the only live
   * interrupt. */
  HAL_RCC_DeInit();
  HAL_DeInit();

  __disable_irq();

  SysTick->CTRL = 0;
  SysTick->LOAD = 0;
  SysTick->VAL  = 0;

  for (uint32_t i = 0; i < 8; i++) {
    NVIC->ICER[i] = 0xFFFFFFFFUL;
    NVIC->ICPR[i] = 0xFFFFFFFFUL;
  }

  SCB->VTOR = APP_BASE;
  __DSB();
  __ISB();

  __set_MSP(sp);
  __set_CONTROL(0);
  __ISB();

  /* PRIMASK is not cleared by reset, and nothing in the application's startup
   * path clears it either, so re-enable interrupts before handing over. */
  __enable_irq();

  ((void (*)(void)) pc)();

  while (1) { }   /* not reached */
}

static void usb_init(void)
{
  /* TinyUSB's dcd_init() does not touch the RCC; in the application this is
   * done by the CubeMX-generated HAL_PCD_MspInit(). There is no PCD here. */
  __HAL_RCC_USB_CLK_ENABLE();

  NVIC_SetPriority(USB_HP_IRQn, 6);
  NVIC_SetPriority(USB_LP_IRQn, 6);
  NVIC_SetPriority(USBWakeUp_IRQn, 6);

  tusb_rhport_init_t dev_init = {
    .role = TUSB_ROLE_DEVICE,
    .speed = TUSB_SPEED_FULL,
  };
  tusb_init(0, &dev_init);
}

/* Smoothstep 3x^2 - 2x^3 on 0..1024, so a ramp eases in and out instead of
 * starting and stopping at a constant slope. */
static uint32_t smoothstep(uint32_t x)
{
  return (x * x * (3U * 1024U - 2U * x)) >> 20;
}

/* One pulse per `period` ms: a quick swell over the first quarter, then a
 * longer fade, both eased. The ramp is in perceived brightness, so it is
 * squared into a duty (about gamma 2); a linear duty would seem to jump on and
 * hang near full. The slower fade after a fast swell is what reads as a pulse
 * rather than a blink. */
static uint32_t pulse_duty(uint32_t now_ms, uint32_t period)
{
  uint32_t const attack = period / 4U;
  uint32_t const phase = now_ms % period;
  uint32_t level;   /* perceived brightness, 0..1024 */

  if (phase < attack)
    level = smoothstep(phase * 1024U / attack);
  else
    level = 1024U - smoothstep((phase - attack) * 1024U / (period - attack));

  return (level * level >> 10) * LED_PEAK_DUTY >> 10;
}

/* Pulse at 2 Hz while waiting, 5 Hz while an image is arriving. */
static void led_task(void)
{
  bool const busy = uf2_receiving() || midi_update_active();
  led_set(pulse_duty(HAL_GetTick(), busy ? 200U : 500U));
}

/* `drive`: also expose the BANDOLIBRE drive (see usb_descriptors.c). */
static void dfu_mode(bool drive)
{
  usb_descriptors_set_drive(drive);
  usb_init();

  while (1) {
    tud_task();
    midi_update_task();
    dfu_runtime_task();
    led_task();

    if (uf2_commit_ready()) {
      /* The drive rewrites the whole application; a web update in progress
       * must not carry on over it. */
      midi_update_cancel();

      /* Keep servicing USB briefly so the transfer that completed the image
       * gets its status stage and the host is not left waiting mid-command;
       * programming blocks for about a second. */
      uint32_t const settle = HAL_GetTick();
      while (HAL_GetTick() - settle < 100U) tud_task();

      led_set(LED_PEAK_DUTY);

      printf("dfu: all blocks received, committing to flash...\r\n");
      if (uf2_commit()) {
        printf("dfu: commit OK, resetting\r\n");
        NVIC_SystemReset();
      }

      /* Programming failed. The application region is now partly erased, so
       * app_valid() will keep the board here after a reset — stay put and let
       * the user retry the copy rather than rebooting into nothing. */
      printf("dfu: commit FAILED, staying in DFU mode\r\n");
      led_set(0);
    }
  }
}

int main(void)
{
  /* Started by the STM32 ROM loader leaving its DFU mode (the update tool's
   * "Exit DFU mode"), not by a reset: it jumps here with its own state left
   * in place, notably VTOR on the ROM's vector table (0x1FFF0000). SysTick
   * then runs the ROM's handler, HAL's tick never advances, and the first
   * HAL_Delay() hangs: that is how a bootloader without this check froze.
   * A reset starts clean, and with FN0 released by now the chip boots from
   * flash. After a real reset the PLL is off, and the memory remap reads 0
   * (main flash; also 0 while SYSCFG's clock is still off). */
  if ((RCC->CR & RCC_CR_PLLON) ||
      (SYSCFG->MEMRMP & SYSCFG_MEMRMP_MEM_MODE) == SYSCFG_MEMRMP_MEM_MODE_0) {
    NVIC_SystemReset();
  }

  HAL_Init();
  SystemClock_Config();
  gpio_init();
  debug_init();

  uint32_t const flag = *boot_flag;
  *boot_flag = 0;   /* one shot: never trap the board in update mode */
  bool const web_request = (flag == BOOT_FLAG_MAGIC_MIDI);
  bool const console_request = (flag == BOOT_FLAG_MAGIC);
  bool const button = dfu_button_pressed();
  bool const valid = app_valid();

  printf("\r\nboot-g474: web=%d console=%d button=%d app_valid=%d\r\n",
         web_request, console_request, button, valid);

  if (web_request || console_request || button || !valid) {
    /* Only a reboot the web tool asked for, onto a valid application, goes
     * without the drive: any other way in may be a recovery that needs it. */
    bool const drive = !web_request || !valid || button;
    printf("boot-g474: entering update mode%s\r\n", drive ? " with the drive" : "");
    dfu_mode(drive);
  }

  printf("boot-g474: jumping to application at 0x%08lx\r\n", (unsigned long) APP_BASE);
  jump_to_app();
  return 0;
}

void Error_Handler(void)
{
  __disable_irq();
  while (1) { }
}

/* A double ECC error on a flash read: a double word torn by a power cut while
 * it was programmed (an update's last write, or a saved-settings record).
 * Clear it (ECCD is write-1-to-clear), flag it for flash_read(), and resume;
 * without this the default handler would hang the bootloader on a board that
 * only needs a new image. */
void NMI_Handler(void)
{
  if ((FLASH->ECCR & FLASH_ECCR_ECCD) != 0U) {
    FLASH->ECCR |= FLASH_ECCR_ECCD;
    flash_ecc_fault = true;
    return;
  }
  while (1) { }
}

/* HAL_Delay() and HAL_GetTick() need the tick interrupt. In the application
 * this handler comes from the CubeMX-generated stm32g4xx_it.c, which this
 * project does not use; without it the weak symbol in the startup file points
 * at Default_Handler and the first HAL_Delay() would hang. */
void SysTick_Handler(void)
{
  HAL_IncTick();
}

/* USB interrupt handlers (override the weak defaults from the startup file) */
void USB_HP_IRQHandler(void)
{
  tud_int_handler(0);
}

void USB_LP_IRQHandler(void)
{
  tud_int_handler(0);
}

void USBWakeUp_IRQHandler(void)
{
  tud_int_handler(0);
}
