bandolibre/bandolibre/code/main-g474/app/bellow_curve_test.c

/* Host unit tests for bellow_curve. Pure C, no HAL — compile and run
 * natively (see `just test`). Same framework as bellow_classify_test.c. */

#include "bellow_curve.h"

#include <stdio.h>
#include <stdint.h>

/* bellow_curve_apply() itself works in 0.0..1.0 now (see bellow_curve.h); this
 * test's expected values are all pre-existing, hand/Python-verified numbers
 * at a 0..BELLOW_INTENSITY_MAX integer scale (no production meaning -- just
 * the scale these values happen to have been computed at), so round-trip
 * every call through the same normalize-in/denormalize-out math
 * bellow_curve_apply() used to do internally, rather than recomputing
 * 37000+ expected values. */
#define BELLOW_INTENSITY_MAX 16384
/* The control points below are in the 1/256 units these values were computed
 * at (the properties now store 0..255 bytes, /255): passed to the curve as
 * 0..1 floats, so the curve math is checked unchanged. */
static uint16_t curve_apply_u16(uint16_t intensity, uint16_t cx1, uint16_t cy1, uint16_t cx2, uint16_t cy2)
{
  float y = bellow_curve_apply_unit((float)intensity / (float)BELLOW_INTENSITY_MAX,
                                    cx1 / 256.0f, cy1 / 256.0f, cx2 / 256.0f, cy2 / 256.0f);
  return (uint16_t)(y * (float)BELLOW_INTENSITY_MAX + 0.5f);
}

static int g_checks;
static int g_failures;

#define CHECK(cond)                                                \
  do {                                                             \
    g_checks++;                                                    \
    if (!(cond)) {                                                 \
      g_failures++;                                                \
      printf("FAIL %s:%d: %s\n", __FILE__, __LINE__, #cond);       \
    }                                                               \
  } while (0)

/* P0=(0,0) and P3=(1,1) are fixed regardless of the two free control
 * points, so the endpoints are pinned for any legal (cx1,cy1,cx2,cy2). */
static void test_endpoints(void)
{
  CHECK(curve_apply_u16(0, 85, 85, 171, 171) == 0);
  CHECK(curve_apply_u16(BELLOW_INTENSITY_MAX, 85, 85, 171, 171) == BELLOW_INTENSITY_MAX);
  CHECK(curve_apply_u16(0, 0, 256, 256, 0) == 0);
  CHECK(curve_apply_u16(BELLOW_INTENSITY_MAX, 0, 256, 256, 0) == BELLOW_INTENSITY_MAX);
  CHECK(curve_apply_u16(0, 0, 0, 256, 256) == 0);
  CHECK(curve_apply_u16(BELLOW_INTENSITY_MAX, 0, 0, 256, 256) == BELLOW_INTENSITY_MAX);
}

/* At the default (both control points on the diagonal: cx1=cy1=85,
 * cx2=cy2=171, the exact same numbers the earlier closed-form design
 * used), the curve degenerates to the line y=x -- any point on the
 * diagonal makes a Bezier collinear, hence straight. Verified by an
 * independent Python re-implementation of this same algorithm (Newton +
 * bisection solve) at BELLOW_INTENSITY_MAX scale to land within [-2,2] of
 * linear at every one of the BELLOW_INTENSITY_MAX+1 possible inputs; the
 * solver's fixed absolute tolerance (1e-4 in normalized [0,1] space) is
 * independent of the output scale, so this bound widens with
 * BELLOW_INTENSITY_MAX rather than staying at the old scale's +-1. */
static void test_near_linear_at_default(void)
{
  for (uint32_t u = 0; u <= BELLOW_INTENSITY_MAX; u++)
  {
    uint16_t v = curve_apply_u16((uint16_t)u, 85, 85, 171, 171);
    int32_t dev = (int32_t)v - (int32_t)u;
    CHECK(dev >= -2 && dev <= 2);
  }
}

/* A hand-traceable case: cx1=cx2=128 puts the control points' X exactly at
 * the domain midpoint, which (like the old design) makes x(t)=t exactly --
 * so this is really just the old 2-control-point-Y curve in disguise, with
 * cy1=0 (slow start), cy2=256 (steep finish). Values below computed
 * independently in Python with the same algorithm at BELLOW_INTENSITY_MAX
 * scale -- not the old 1024-scale values multiplied by 16, which would be
 * off by several units at each non-exact point (only the exact midpoint,
 * 8192, scales cleanly). */
static void test_hand_traceable_case(void)
{
  CHECK(curve_apply_u16(0, 128, 0, 128, 256) == 0);
  CHECK(curve_apply_u16(4096, 128, 0, 128, 256) == 1735);
  CHECK(curve_apply_u16(8192, 128, 0, 128, 256) == 8192);
  CHECK(curve_apply_u16(12288, 128, 0, 128, 256) == 14649);
  CHECK(curve_apply_u16(16384, 128, 0, 128, 256) == 16384);
}

/* Degenerate corner: cx1=cx2=0 makes x(t)=t^3, so the solver's derivative
 * at the very start of the curve (t near 0) is close to zero -- exactly
 * the case the bisection fallback exists for. Confirms no crash/NaN and
 * that the result stays monotonic through the degenerate region rather
 * than stalling or oscillating. */
static void test_degenerate_flat_start(void)
{
  /* Inputs are the old 1024-scale sample points x16 (same relative
   * positions); expect[] is independently recomputed at BELLOW_INTENSITY_MAX
   * scale, not the old expect[] x16 -- rounding at the wider scale doesn't
   * land on the same values (off by several units at multiple points). */
  static const uint32_t expect[] = {0, 2212, 4291, 7706, 10282, 12216, 13779, 16384};
  static const uint32_t inputs[] = {0, 16, 160, 1600, 4800, 8192, 11200, 16384};
  uint16_t prev = 0;
  for (size_t i = 0; i < sizeof(inputs) / sizeof(inputs[0]); i++)
  {
    uint16_t v = curve_apply_u16((uint16_t)inputs[i], 0, 128, 0, 128);
    CHECK(v == expect[i]);
    CHECK(v >= prev);
    prev = v;
  }
}

/* Monotonicity is proven analytically for the entire (cx1,cy1,cx2,cy2) in
 * [0,256]^4 range (see bellow_curve.h): x(t) and y(t) are each guaranteed
 * monotonic on their own, and a monotonic function of a monotonic function
 * is monotonic. This sweeps a grid of control points and asserts the
 * *coded* solver never produces a decrease as the input rises -- a
 * regression net against implementation bugs (solver mis-convergence,
 * sign errors) that the proof of the intended math wouldn't catch. */
static void test_monotonic_sweep(void)
{
  static const uint16_t vals[] = {0, 64, 128, 192, 256};
  size_t n = sizeof(vals) / sizeof(vals[0]);
  for (size_t a = 0; a < n; a++)
    for (size_t b = 0; b < n; b++)
      for (size_t c = 0; c < n; c++)
        for (size_t d = 0; d < n; d++)
        {
          uint16_t prev = 0;
          for (uint32_t u = 0; u <= BELLOW_INTENSITY_MAX; u += 512)
          {
            uint16_t v = curve_apply_u16((uint16_t)u, vals[a], vals[b], vals[c], vals[d]);
            CHECK(v >= prev);
            prev = v;
          }
        }
}

/* The byte form the properties use: 255 is exactly 1, so the line through
 * (85,85), (170,170), at 1/3 and 2/3, is y = x. */
static void test_byte_scale(void)
{
  CHECK(bellow_curve_apply(1.0f, 0, 0, 255, 255) == 1.0f);
  for (int i = 0; i <= 16; i++)
  {
    float x = (float)i / 16.0f;
    float y = bellow_curve_apply(x, 85, 85, 170, 170);
    CHECK(y > x - 0.002f && y < x + 0.002f);
  }
}

int main(void)
{
  test_endpoints();
  test_near_linear_at_default();
  test_hand_traceable_case();
  test_degenerate_flat_start();
  test_monotonic_sweep();
  test_byte_scale();

  printf("%d checks, %d failures\n", g_checks, g_failures);
  return g_failures != 0;
}
