bandolibre/bandolibre/(commit log)

2026-06-30 Add a button to github.
2026-08-10 Use github button in documentaiton
2026-09-13 Add midi sysex framework.
2026-09-13 Reduce debug flash binary footprint.
2026-09-13 Modernize MIDI subsystem to pure C++ with span
    Replace pointer+size patterns with gsl::span throughout. Convert
    midi.h to C++-only API, move cmd.c to cmd.cc for interop, use
    constexpr for constants, and drop all extern C wrappers.
    [app.cc, cmd.cc, cmd.h, main.c, midi.cc, midi.h]
2026-09-14 Refactor bellows response curve into separate module with cubic-Bezier shaping
    Extracts bellows response curve handling into a dedicated bellow_curve module
    with parametric cubic-Bezier response shaping (four control point parameters).
    This replaces an earlier closed-form design and enables flexible, monotonic
    response curves via Newton-Raphson solver. Includes comprehensive unit tests.
    [bellow.c, bellow_curve.c, bellow_curve.h, bellow_curve_test.c, keyboard.cpp, keyboard.h, midi.cc, properties_test.c]
2026-09-14 Fix sysex escaping with 7-bit packing
    [tusb_config.h]
2026-09-14 Better event filtering, and layout tuning.
2026-09-15 Add keyboard visualisation.
    [bandolibre.eprj, keyboard_mapping.csv]
2026-09-15 Add function buttons and a synth to th HTML tool page.
2026-09-15 Fix bandoneon reconnect and simplify console output.
    [cmd.cc, properties_console.c, properties_console.h, properties_test.c]
2026-09-16 Fix eyboard mapping errors.
    [keyboard_layout.c]
2026-09-16 Update DFU procedure.
    [keyboard_mapping.csv]
2026-09-16 Fix discrepancy in bellow ADC resolution
    [main-g474.ioc, main.c]
2026-09-18 Decouple 1euro filter and hysteresis processing
2026-09-18 Tune filters and curve.
2026-09-20 Add panelization tool.
    [bandolibre.eprj]
2026-09-30 Add interest list button and configuration tool overview to readmes.
2026-09-30 Give the configuration tool its own readme section with a link button and screenshots.
2026-09-30 Shrink readme buttons, left-align interest list with form icon, fix release link.
2026-09-30 Add email button to the community section of the readmes.
2026-09-30 Point the GitHub button to the main project repository.
2026-09-30 Add sound synthesis section with FlowTones MIDI learn guide to user manual.
2026-09-30 User manual: overview photo, config tool button, iOS sound options, invite feedback.
2026-09-30 Add user manual button to readmes and use a hammer icon for assembly instructions.
2026-09-30 Tighten user manual wording and add license section.
2026-09-30 Add French and Spanish user manuals with language switcher.
2026-09-30 Reword the interest list heading and button so they no longer read as a waiting list.
2026-09-30 Call the right button setting keyboard system instead of tuning.
2026-10-01 Bellows: replace the sensitivity levels with three bellows programs.
    - FN1 cycles the programs; the configuration tool selects and edits them.
    - README, features and user manual updated in three languages.
    [bellow.c, bellow.h, buttons.c, buttons.h, properties_test.c]
2026-10-01 Configuration tool: show keyboard systems as buttons and follow the function buttons.
    - The peripherals poll now carries table mode, tuning and bellows program.
2026-10-01 USB docs: describe the device as MIDI-only and document the SysEx framing.
    - usb/README.md: fix the usb_app.cc name, list the MIDI senders, explain the 7-bit SysEx packing.
    - Remove stale CDC mentions from usb_descriptors.c and usb_app.cc comments.
2026-10-04 Configuration tool: show the connection status next to the MIDI device picker.
2026-10-04 Configuration tool: say when the selected MIDI device doesn't answer, likely not the Bandolibre.
2026-10-04 Configuration tool: rename the bellows center button to Calibrate and give it an icon.
2026-10-04 Properties: keep saved values in flash, overriding the factory values at boot.
    - SysEx: get/set saved value and factory reset, for the configuration tool.
    - Console: save, factory_reset and store; show lists saved and factory values.
    - flash.py and uf2.py refuse images that would reach the saved values.
    - User manual updated in three languages.
    [app.cc, cmd.cc, fake_flash.h, flash_page.c, flash_page.h, flash_write.c, flash_write.h]
2026-10-04 Configuration tool: move the function buttons above the bellows, with the program choice.
    - Rename the curve presets.
    - Tidy captions.
2026-10-04 Configuration tool: add a Save as default button for the bellows center.
    - Center the button labels.
    - Size the Name column to the longest property.
2026-10-04 Main firmware: print floats without printf's %f, saving 9.8 KB of flash.
    - Add fixed_format() with host tests; the bellows report uses it.
    - Build syscalls.c without LTO so the Release link still finds _fstat and _isatty.
    [bellow.c, fixed_format.c, fixed_format.h, fixed_format_test.c]
2026-10-04 Properties: save every property and number the tags 1 to 71 in table order.
    - table_mode is now saved, so table mode survives a reboot once saved.
    - Log and live-report switches are saved too when they differ at Save time.
    - Each bellows program takes 11 consecutive tags, with no retired gaps.
    [properties_test.c, property_store.h, property_store_test.cc]
2026-10-04 Documentation: swap the left and right function buttons.
    - Left button: keyboard system and firmware update; right button: table mode.
2026-10-04 Firmware: swap the left and right function buttons in the comments.
    [buttons.h, main.c]
2026-10-04 Bellows: hold the middle button for one second to calibrate and save the center.
    - A short press of the middle button now changes the bellows program on release.
    - The middle button's light is on while the center is measured.
    - The new center is pushed to the configuration tool, which updates the graph and table.
    - Configuration tool: device push messages no longer get taken as the reply to a pending request.
    - User manual: new Getting started and Bellows calibration sections.
    [bellow.c, bellow.h, buttons.c, buttons.h, midi.cc, midi.h]
2026-10-04 Configuration tool: show the bellows center calibrated with the middle button.
2026-10-04 Configuration tool: warn when a newer firmware is released on GitHub.
    - The activity filters are kept across page reloads.
2026-10-05 Configuration tool: move the properties' show all switch into the menu.
2026-10-05 Configuration tool: pack the keyboard diagrams tighter and name them Left and Right.
    - Keys sit 20% closer; keys and note names keep their size.
    - "Wing" is the board name, no longer shown in the tool.
2026-10-09 Function button LEDs: dim all three with PWM and show table mode, bellows program and tuning.
    - FN0 is off or full for table_mode; FN1 and FN2 are off, pulsing 30-70%, full for the three bellows programs and tunings.
    - The bootloader pulses LED_FN2 at 2 Hz in DFU mode, 5 Hz while receiving.
2026-10-09 Add the led_max_duty property for the function button LED brightness.
    - It is the PWM duty of a 100% LED, 0 to 1023, factory value 1023.
2026-10-09 Console: `get` prints a table of all property fields, `help` no longer lists properties.
    - get shows type, [min, max], value, default, firmware value and description, under a highlighted header.
    - Console output ends lines with CR LF, so the Tab completion list is no longer erased by the prompt.
    - Ctrl-L redraws the prompt.
    [ansi.h, cmd.cc, config.h, console.c, properties_console.c, properties_console.h]
2026-10-09 Move the documentation into docs/guide so the site can publish it.
    - The guide pages render with the site's theme, with a Guide menu entry and a landing page.
    - Links that left the documentation now use GitHub URLs; README links and the patch path follow the move.
2026-10-09 Site: add a user manual section with a button to the manual on the Bandolibre page.
2026-10-24 MIDI tool: also detect the board by its USB manufacturer name, as shown on Windows.
2026-10-25 Main boards: add a polyfuse and neopixels.
2026-10-25 Key velocity: time key strike and release, and tune them in a new Key card of the MIDI tool.
    - velocity_source 1 maps the strike speed to note-on velocity and the release speed to note-off velocity (properties 74 to 95).
    - Note offs carry a velocity: 64 when it is not measured.
    - GET_PERIPHERALS is now MONITOR_LEASE: the device sends its push messages only while the tool polls it, and reports the last key pressed.
    - New KEY_STRIKE and KEY_RELEASE push messages plot each note on the tool's graphs.
    - The tool ignores a reply that doesn't match its request, so a second open page no longer breaks the connection.
    - The console's send_note_off takes an optional velocity.
2026-10-25 MIDI tool: make the Pedals card collapsible.
    - Remove the empty space under the MIDI device hint.
    - Key card: the velocity captions say note-on and note-off.
2026-10-25 MIDI tool: hatch the Key press and Key release boxes while the velocity comes from the bellows.
2026-10-25 Config tool: each curve control point in one field, as in the properties table.
    - Bellows graph labels say push and pull travel, at the axis text size; y axis reads "expression CC#11".
    - Key thresholds dashed like the pedal lines; the Triggering box is now Key triggering.
2026-10-25 Config tool: the bellows graph keeps enough x-axis ticks when zoomed.
2026-10-25 Web tool: mark the three stops of the bellows zoom switch with dim dots.
2026-10-25 Flash tools: name the ST-Link by its serial, and retry under reset.
    - Without it, st-flash could open the main board's own USB port and fail.
2026-10-25 Firmware: a velocity lease that switches note velocity to key speed while bandopm holds it.
    - SYSEX 0x0C, renewed every second: sets velocity_source to key speed (not saved), and restores it 2 s after the last renewal unless it was changed meanwhile.
    - Both changes are pushed as PROPERTY_CHANGED, so the configuration tool follows them.
    - Config tool: "Velocity from" choices are Bellows and Key speed.
2026-10-27 USB: use "Bandolibre" as manufacturer too, so the MIDI port has the same name on Windows and macOS.
    - Web tool: recognize the board by "Bandolibre" in the port name only.
    - Boards on older firmware are no longer found on Windows: update the firmware.
2026-10-27 Firmware update from the browser over USB-MIDI, with the new update tool at docs/update/.
    - The bootloader is now a MIDI device, "Bandolibre firmware update", and takes the firmware over SysEx; the BANDOLIBRE drive stays for FN2 and recovery.
    - An interrupted update leaves the instrument in update mode, ready to resume.
    - The configuration tool moves to docs/connect/; docs/tools/midi.html redirects there.
    - Debug builds now run above the bootloader too: install it once per board with `cd code/boot-g474 && just flash`.
2026-10-27 Update tool: fireworks when an update completes, and a simpler, steadier layout.
    - The instrument card shows the mode in the status and an "up to date" / "update available" badge next to the firmware.
    - The update button is highlighted only when there is something to install.
    - A .uf2 can be dropped anywhere on the "Latest firmware" card, which glows while a file is dragged over the page.
    - Nothing moves while the page loads, and it fits a phone screen without scrolling.
2026-10-27 Update tool: install firmware on a board in STM32 DFU mode (FN0), over WebUSB.
    - Works in Chrome and Edge with the same .uf2; each page is read back and compared, page 0 written last.
    - Refuses a board without the Bandolibre bootloader.
    - The left keyboard must be unplugged: it otherwise takes over the chip's loader.
    - Linux needs a udev rule once, shown with a copy button; Windows needs the WinUSB driver.
2026-10-27 Update tool: install the bootloader in STM32 DFU mode, and an Exit DFU mode button.
    - Dropping a bootloader .uf2 (`just uf2` in code/boot-g474) switches the page to Install bootloader, enabled in DFU mode only.
    - Exit DFU mode restarts the board without unplugging it; the bootloader resets the chip when the ROM loader jumps into it.
    - The board needs this bootloader before Exit DFU mode works: install it once from DFU mode.
2026-10-28 Bootloader: explain why leaving the ROM's DFU mode froze the board without the reset check.
2026-10-28 Release .uf2: carry the bootloader next to the firmware.
    - `just dfu` builds both into one file, as two UF2 files back to back; the drive and the MIDI update install the firmware part only.
    - In STM32 DFU mode the update tool rewrites the bootloader only when the board's differs, then writes the firmware.
    - The update tool shows the firmware and bootloader versions of the loaded file.
2026-10-28 Restart into the STM32 DFU mode from USB, without FN0.
    - Application and bootloader carry a USB DFU runtime interface; DFU_DETACH restarts the board into the chip's loader (code/common/dfu/).
    - The keyboards restart into their own loaders first, so the left one no longer blocks USB; the application restarts them at start.
    - Update tool: Restart in DFU mode button; one udev rule covers both devices.
    - bcdDevice now 0x0101, 0x0203 and 0x0204; bcdUSB 2.1 with Microsoft OS 2.0 descriptors for WinUSB.
    - Console command romdfu.
2026-10-28 Update tool: the progress grid shows the whole flash, in bootloader, firmware and saved settings groups.
    - Areas this mode can't write are outlined: the bootloader outside DFU mode, the saved settings always.
    - After a DFU install the button turns plain until the board reconnects.
    - The DFU notice stays up during an install, with Exit DFU disabled.
    - "The firmware and the bootloader are installed".
2026-10-28 Configuration and update tools: the PWA install button is an Install chip with Chrome's install icon.
2026-10-28 Web tools: the Bandolibre wordmark in the titles and About boxes; the update tool becomes Bandolibre Software Update.
    - "Bando" handwritten as in BandoPM (its font, embedded), "libre" in the system font.
    - Configuration tool: a subtitle like the update tool's.
    - Update tool: the Instrument card loses its "Device" label; the firmware badge lines up with the status light.
2026-10-28 README and project page: the software update tool, and the Bandolibre wordmark on the site.
    - README (three languages): a Software update section with its button; the firmware update line points to the tool.
    - Project page: the update section opens the tool; the title and the menu use the wordmark.
2026-11-05 Wing boards: SPI on the system bootloader pins, and 330 Ω series resistors on the wing bus.
    - Wing SPI1 MISO/MOSI move from PB4/PB5 to PA6/PA7; A_IN2/A_IN3 move to PA2/PA3 (ADC1), A_IN0/A_IN1 are read by ADC2.
    - Wing SEL0/SEL1 move to PF0/PF1 and ID1/ID2 to PC14/PC15.
    - 330 Ω in series on SPI NSS/SCK/MOSI (wing side) and MISO (main side); READY, NRST and BOOT0 series resistors go from 100 Ω to 330 Ω.
    - Wing READY LED removed; power LED resistors go to 470 Ω (C23179) on all three boards.
    - Wing firmware not updated yet: regenerate Core/ and change the ADC channels in app.cc.
2026-11-05 User manual: update in DFU mode from the browser, and the browser grids for both updates.
    - DFU mode: how to enter it, its WebUSB browser grid, and the WinUSB driver with Zadig on Windows.
    - The browser update says it goes over MIDI SysEx, with the Web MIDI grid.
    - Guide contents list only the main sections.
2026-11-05 Bellows programs: add a per-program switch to drop a program from the FN1 cycle.
    - New bellow_p<n>_in_cycle property, on by default; FN1 skips a program whose switch is off.
    - Each program now owns 8 tags (4-27); tags 28-39 are reserved for future program properties; the rest move up.
    - Saved values from earlier builds land on the wrong property: factory reset.
2026-11-05 User manual: center the images, link the BandoPM picture to the app, and explain when DFU mode needs the keyboards unplugged.
    - Not starting happens with early firmware and hardware; open the case before unplugging the keyboards.
2026-11-05 Web tools: the device list no longer blinks while open on Android.
    - The list is rebuilt only when the devices change, not on every poll.
2026-11-05 Configuration tool: fit small screens and even out the type sizes.
    - Properties table stacks each row on phones; tighter page padding.
    - Smaller sensor → CC readouts and pedal status lines.
    - Bellows status says "Connected live"; Shift hints shown as a key.
