bandolibre/bandolibre/(notices)

Notices in the files:
code/main-g474/Core/Src/main.c:
Copyright (c) 2026 STMicroelectronics.
All rights reserved.
This software is licensed under terms that can be found in the LICENSE file
README.md:
License:
[CC BY-NC-SA 4.0](LICENSE.md)
docs/index.md:
https://mirrors.creativecommons.org/presskit/buttons/88x31/svg/by-nc-sa.eu.svg
